goodrobots/devFrame/README.md

# devFrame
The Development Frame, or devFrame, is an easy to build and maintain multicopter frame. 

This is a Work In Progress.

Docs here:  https://goodrobots.github.io/devFrame/

Licensed under CERN OHL v.1.2
