goodrobots/devFrame/docs/_docs/41-basic-camera.md

---
title: "Basic Camera"
permalink: /docs/basic-camera/
---

Coming Soon.
