goodrobots/devFrame/docs/assets/images/battery-etc/bec-cross-mount.jpeg

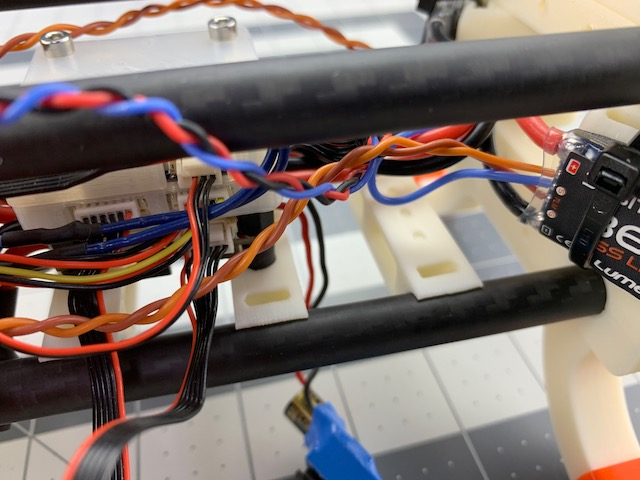
docs/assets/images/battery-etc/bec-cross-mount.jpeg
