goodrobots/devFrame/docs/assets/images/d300 4in1.jpeg

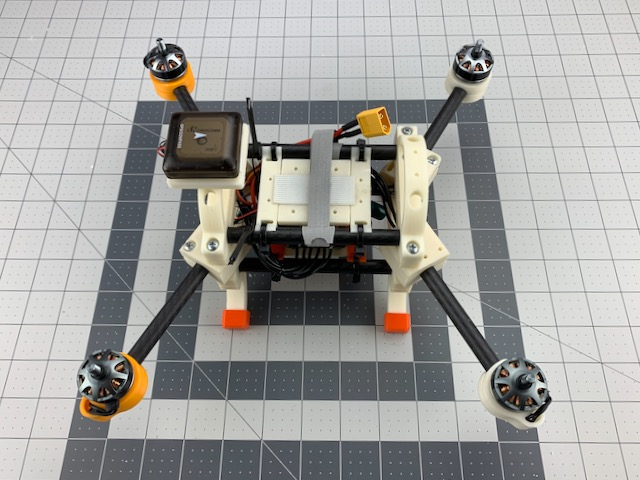
docs/assets/images/d300 4in1.jpeg
