goodrobots/devFrame/docs/assets/images/devFrame-internal-volume-example.jpeg

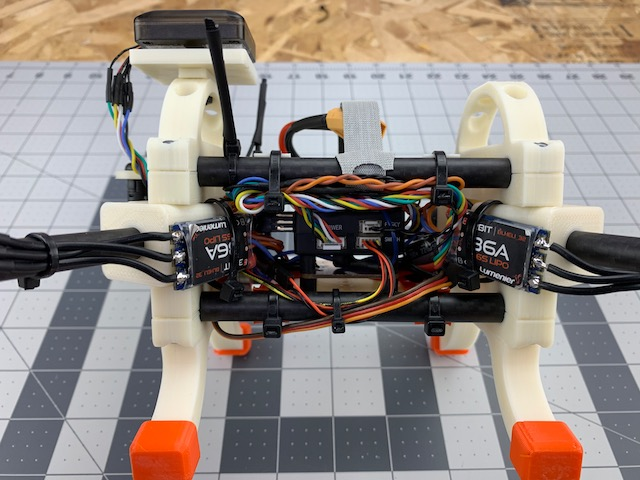
docs/assets/images/devFrame-internal-volume-example.jpeg
