goodrobots/devFrame/docs/assets/images/devFrame-mounts-example.jpeg

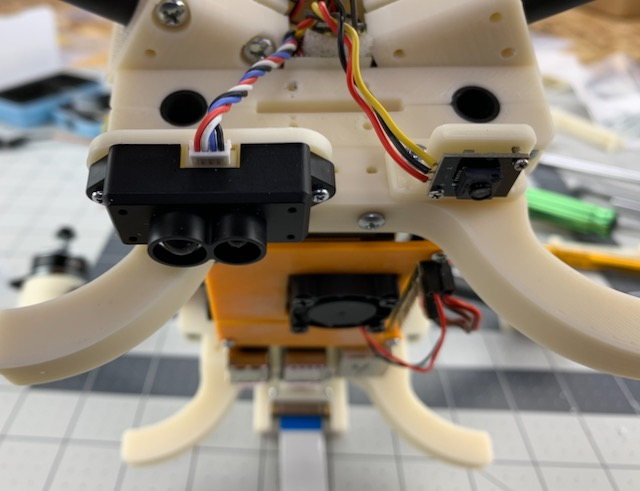
docs/assets/images/devFrame-mounts-example.jpeg
