goodrobots/devFrame/docs/assets/images/frame-details/arm-tube-mount.jpeg

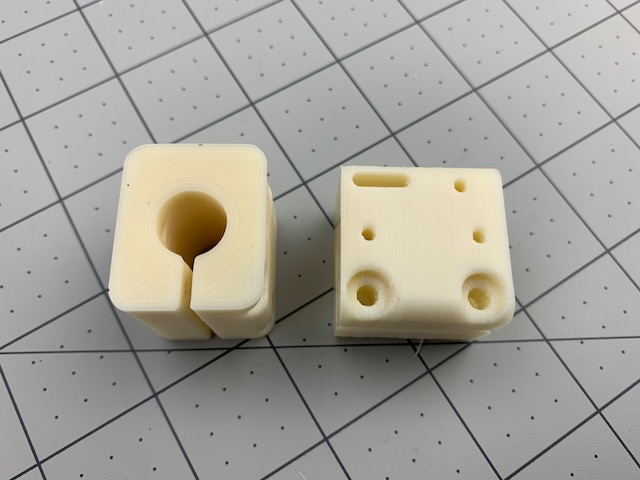
docs/assets/images/frame-details/arm-tube-mount.jpeg
