goodrobots/devFrame/docs/assets/images/frame-details/box-end-roll-cage.jpeg

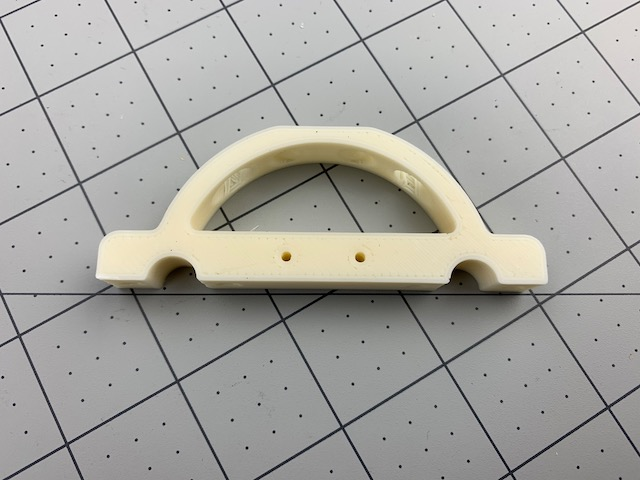
docs/assets/images/frame-details/box-end-roll-cage.jpeg
