goodrobots/devFrame/docs/assets/images/frame-details/box-end-rounded.jpeg

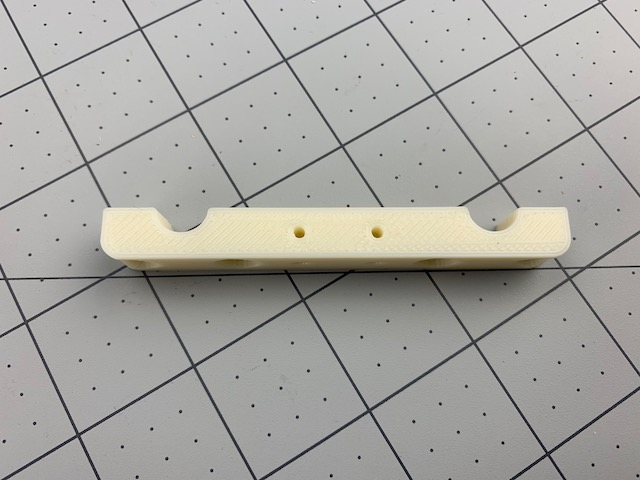
docs/assets/images/frame-details/box-end-rounded.jpeg
