goodrobots/devFrame/docs/assets/images/frame-details/box-end-square.jpeg

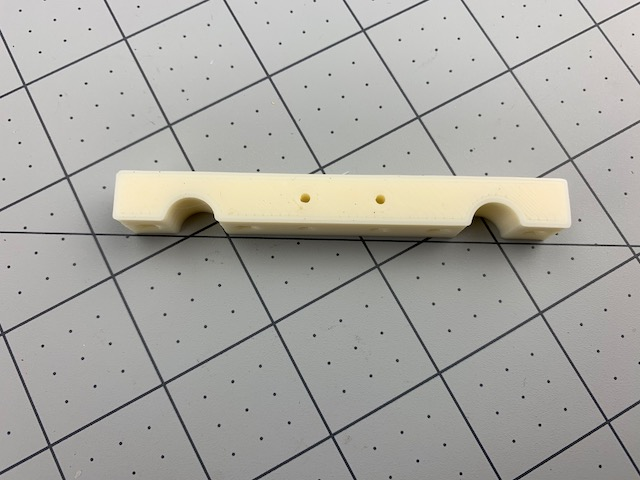
docs/assets/images/frame-details/box-end-square.jpeg
