goodrobots/devFrame/docs/assets/images/frame-details/landing-gear-cap-tpu.jpeg

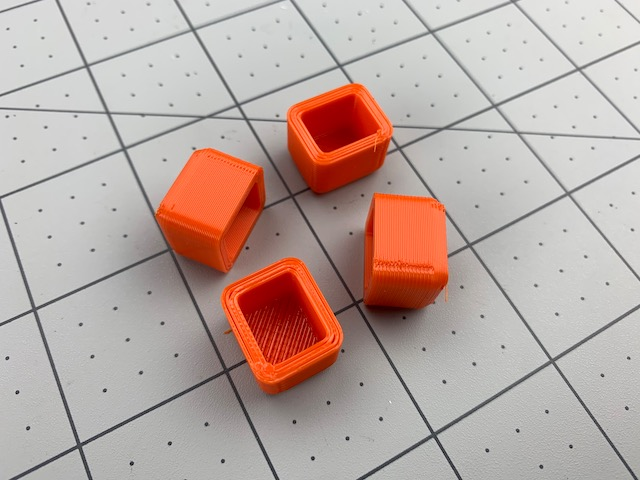
docs/assets/images/frame-details/landing-gear-cap-tpu.jpeg
