goodrobots/devFrame/docs/assets/images/frame-details/landing-gear-spacer.jpeg

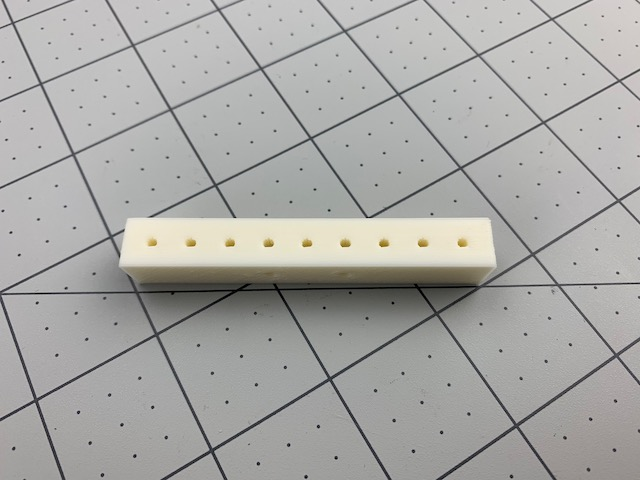
docs/assets/images/frame-details/landing-gear-spacer.jpeg
