goodrobots/devFrame/docs/assets/images/frame-details/landing-gear.jpeg

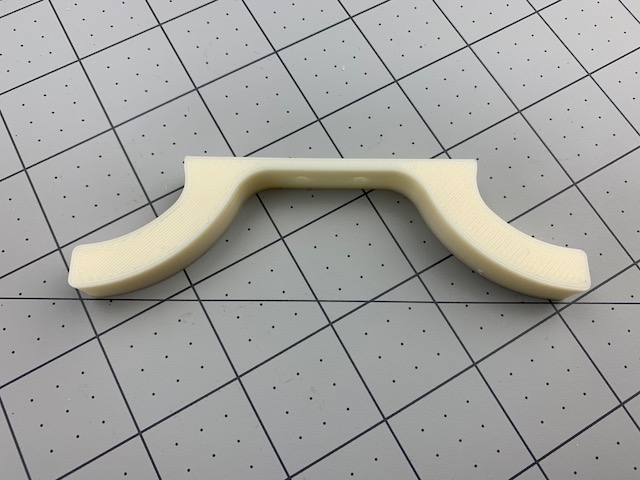
docs/assets/images/frame-details/landing-gear.jpeg
