goodrobots/devFrame/docs/assets/images/frame-details/motor-mount-half.jpeg

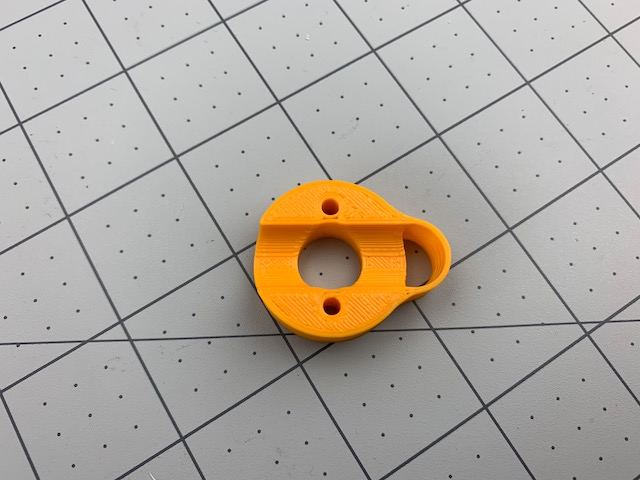
docs/assets/images/frame-details/motor-mount-half.jpeg
