goodrobots/devFrame/docs/assets/images/gps-sensors/gps-tools.jpeg

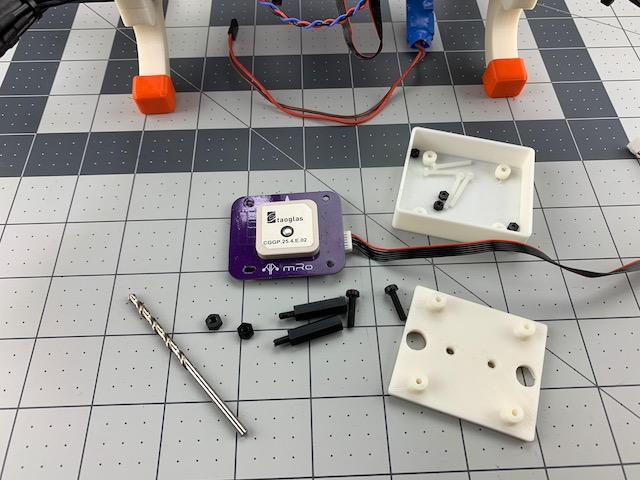
docs/assets/images/gps-sensors/gps-tools.jpeg
