goodrobots/devFrame/docs/assets/images/gps-sensors/receiver-antenna-tools.jpeg

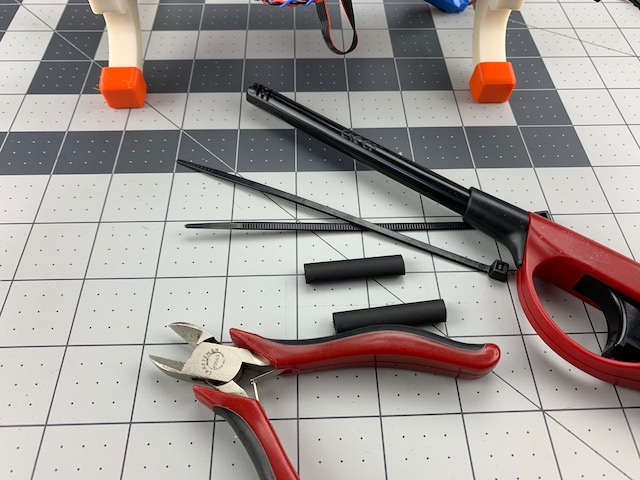
docs/assets/images/gps-sensors/receiver-antenna-tools.jpeg
