goodrobots/devFrame/docs/assets/images/gps-sensors/receiver-cross-mount.jpeg

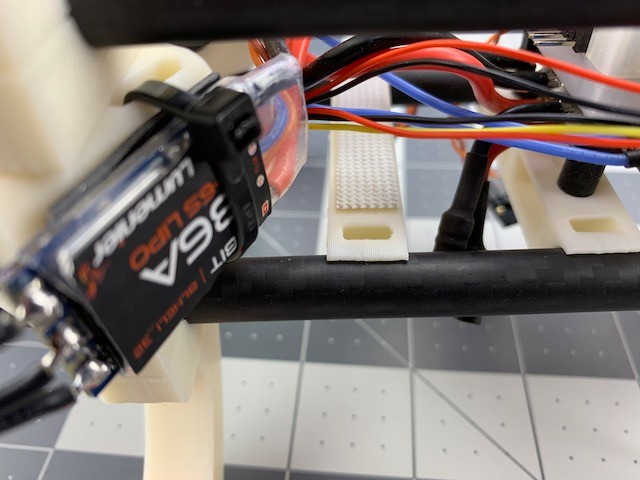
docs/assets/images/gps-sensors/receiver-cross-mount.jpeg
