goodrobots/devFrame/docs/assets/images/gps-sensors/receiver-tools.jpeg

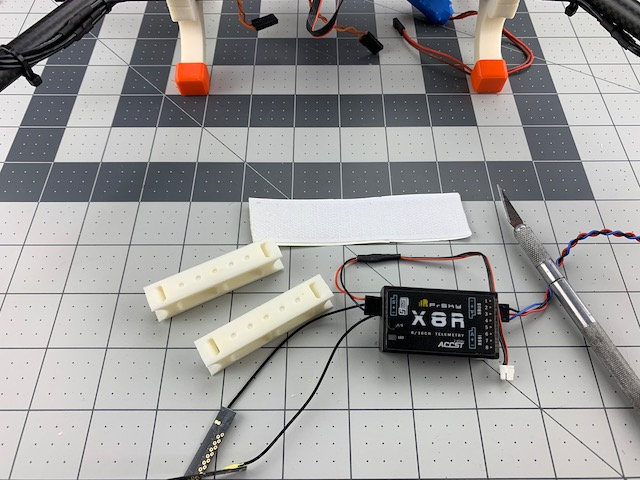
docs/assets/images/gps-sensors/receiver-tools.jpeg
