goodrobots/devFrame/docs/assets/images/gps-sensors/receiver-wires.jpeg

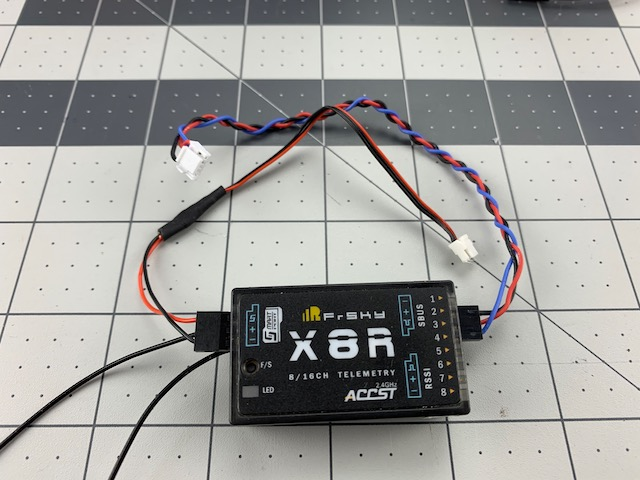
docs/assets/images/gps-sensors/receiver-wires.jpeg
