goodrobots/devFrame/docs/assets/images/gps-sensors/tfmini-back.jpeg

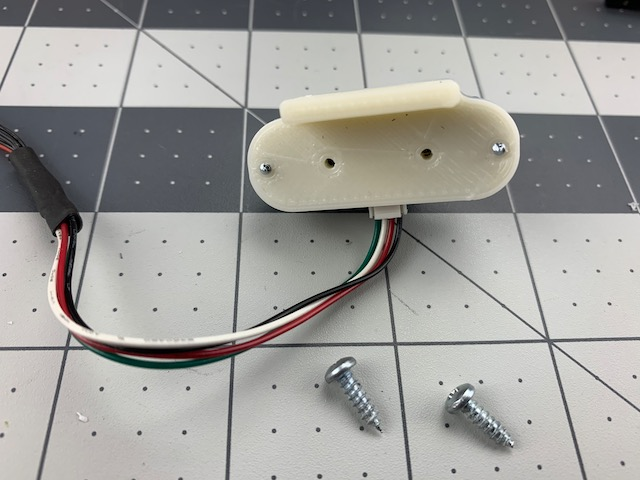
docs/assets/images/gps-sensors/tfmini-back.jpeg
