goodrobots/devFrame/docs/assets/images/gps-sensors/tfmini-front.jpeg

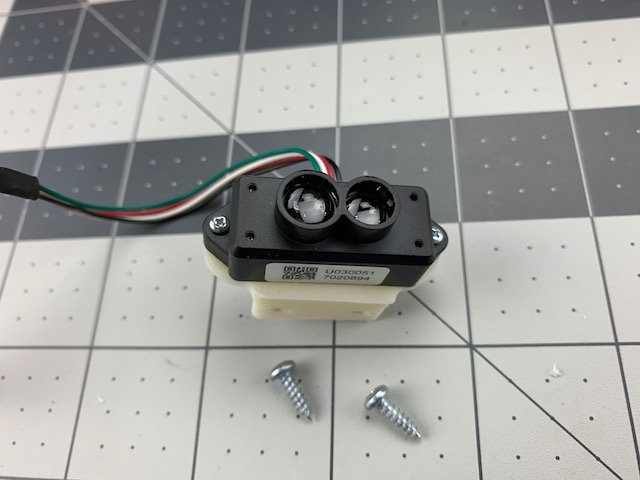
docs/assets/images/gps-sensors/tfmini-front.jpeg
