goodrobots/devFrame/docs/assets/images/gps-sensors/tfmini-prep.jpeg

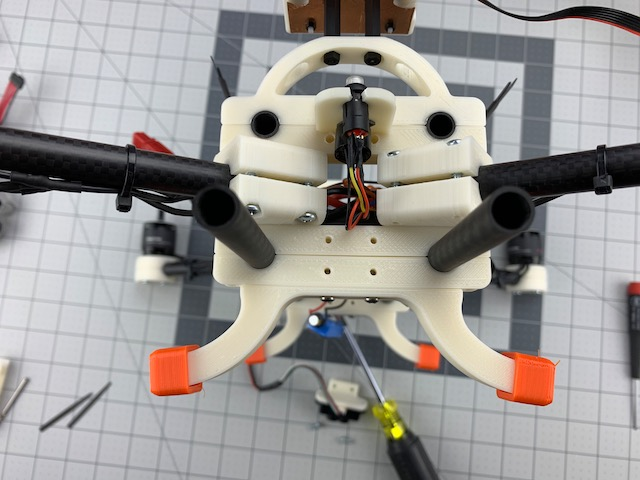
docs/assets/images/gps-sensors/tfmini-prep.jpeg
