goodrobots/devFrame/docs/assets/images/power-esc-motors/5v-bec.jpeg

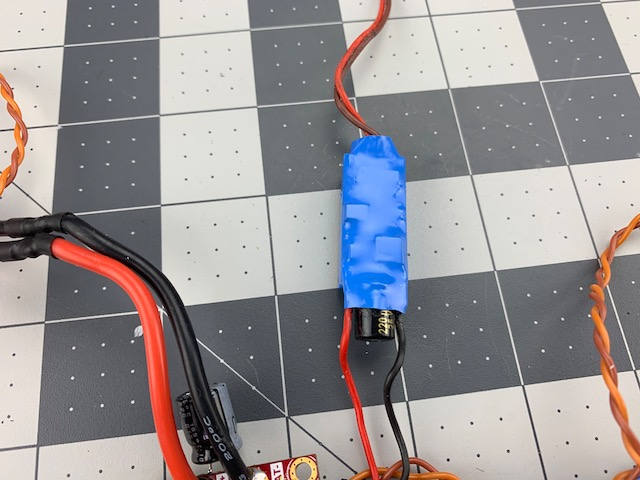
docs/assets/images/power-esc-motors/5v-bec.jpeg
