goodrobots/devFrame/docs/assets/images/power-esc-motors/2213-motor.jpeg

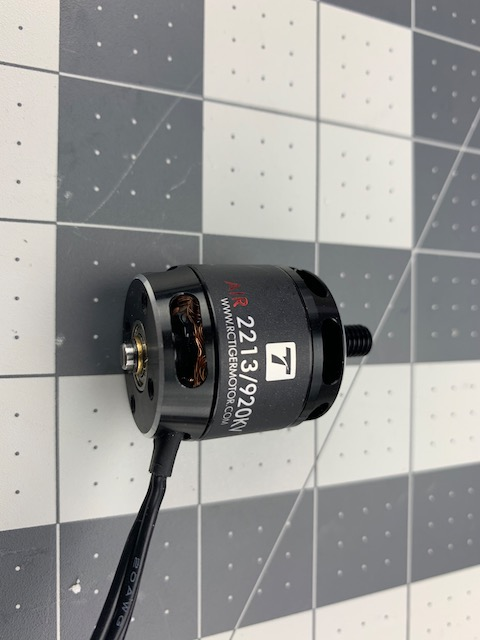
docs/assets/images/power-esc-motors/2213-motor.jpeg
