goodrobots/devFrame/docs/assets/images/power-esc-motors/motor-arm-wire-tools.jpeg

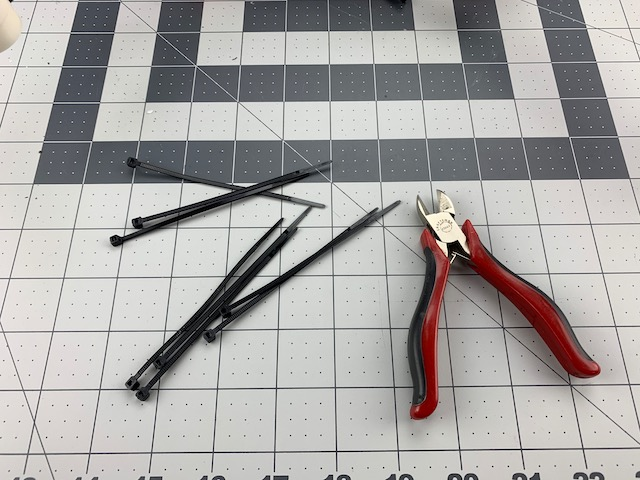
docs/assets/images/power-esc-motors/motor-arm-wire-tools.jpeg
