goodrobots/devFrame/docs/assets/images/power-esc-motors/nylon-standoffs.jpeg

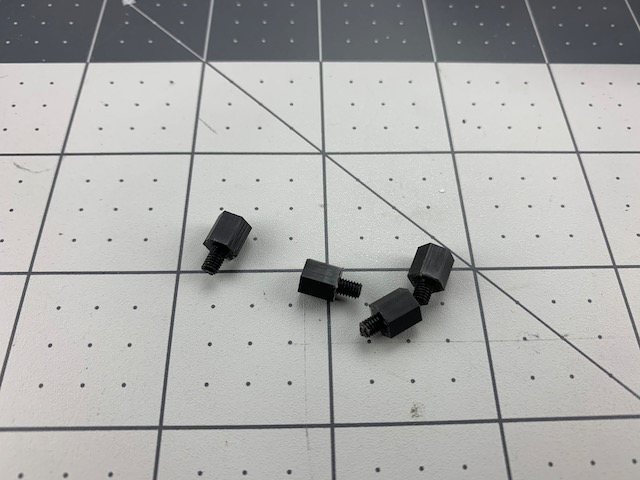
docs/assets/images/power-esc-motors/nylon-standoffs.jpeg
