goodrobots/devFrame/docs/assets/images/power-esc-motors/pdb-acsp4.jpeg

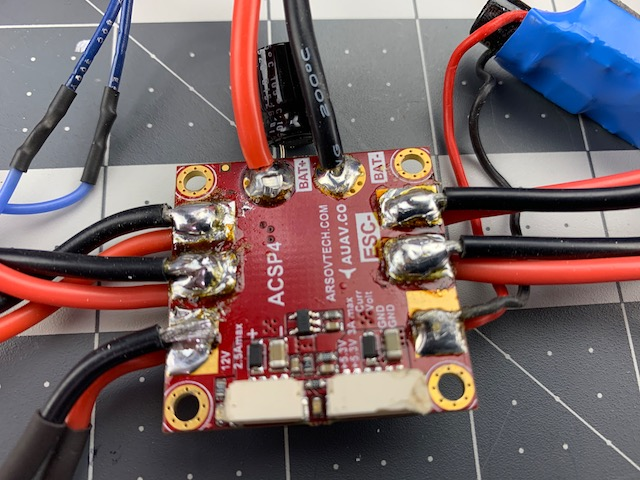
docs/assets/images/power-esc-motors/pdb-acsp4.jpeg
