goodrobots/devFrame/step/Accessory Mounts/Benewake/devFrame TFMini Mount Angle.step

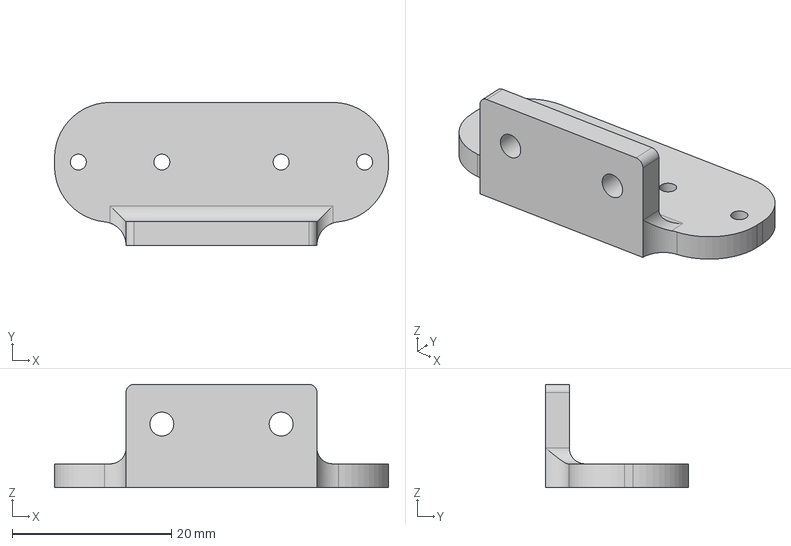
[picture p101: CAD file, 2020-01-14]
step/Accessory Mounts/Benewake/devFrame TFMini Mount Angle.step
42.0 x 18.0 x 13.0 mm
