goodrobots/devFrame/step/Accessory Mounts/CUAV/devFrame CUAV NEO V2 GPS Mount Flat.step

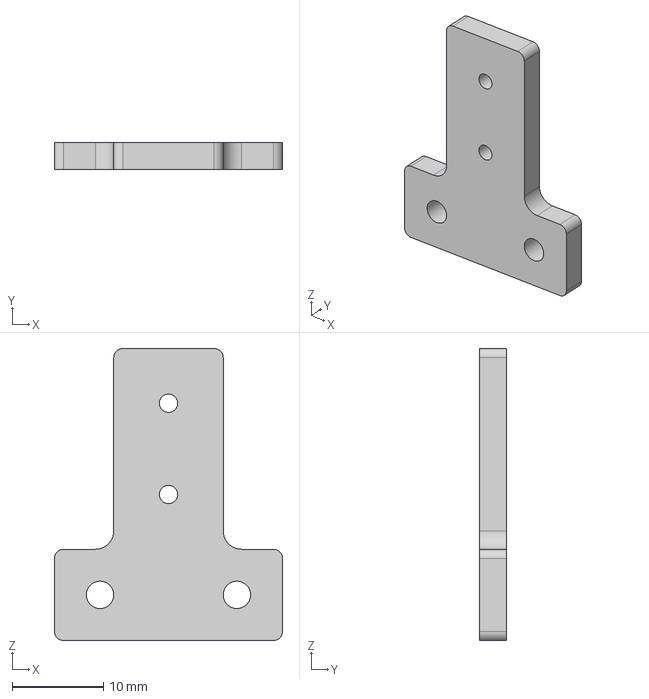
[picture p102: CAD file, 2020-02-13]
step/Accessory Mounts/CUAV/devFrame CUAV NEO V2 GPS Mount Flat.step
25.0 x 3.00 x 32.0 mm
