goodrobots/devFrame/step/Accessory Mounts/Generic/devFrame Platform Mount Shim.step

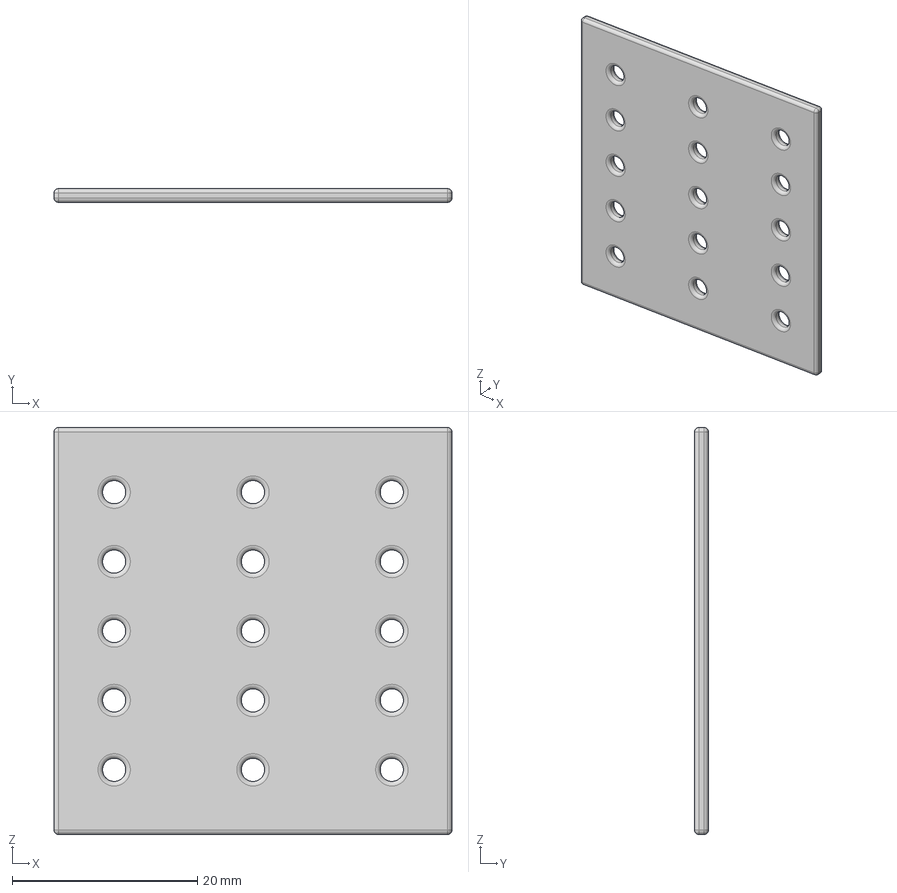
[picture p103: CAD file, 2020-02-05]
step/Accessory Mounts/Generic/devFrame Platform Mount Shim.step
43.0 x 1.50 x 44.0 mm
