goodrobots/devFrame/step/Accessory Mounts/mRo/devFrame mRo GPS Cover.step

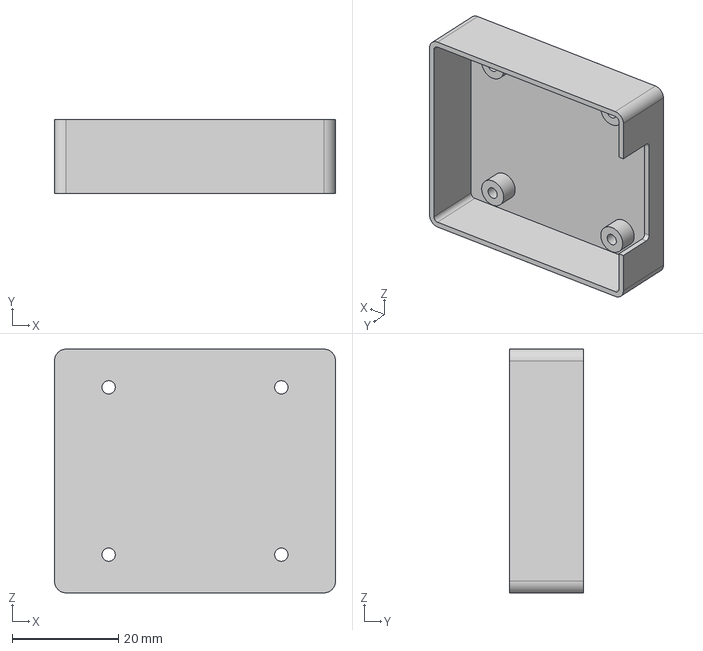
[picture p104: CAD file, 2020-01-12]
step/Accessory Mounts/mRo/devFrame mRo GPS Cover.step
52.9 x 14.0 x 45.9 mm
