goodrobots/devFrame/step/Accessory Mounts/NVIDIA/devFrame NVidia Jetson Nano Mount.step

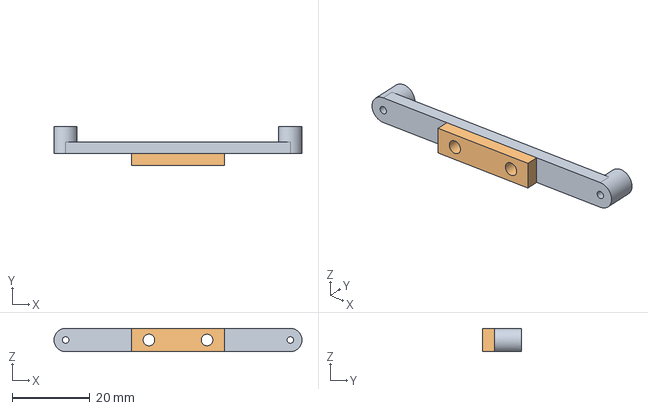
[picture p105: CAD file, 2020-02-10]
step/Accessory Mounts/NVIDIA/devFrame NVidia Jetson Nano Mount.step
64.0 x 10.0 x 6.00 mm
