goodrobots/devFrame/step/Accessory Mounts/RPi/devFrame RPi0 Mount Tall.step

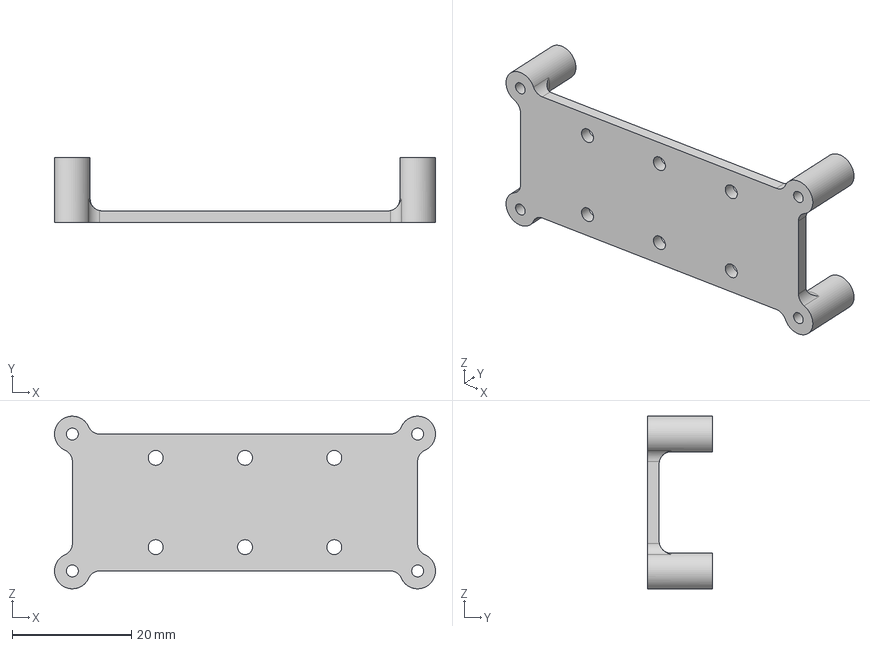
[picture p106: CAD file, 2020-01-19]
step/Accessory Mounts/RPi/devFrame RPi0 Mount Tall.step
64.0 x 11.0 x 29.0 mm
