goodrobots/devFrame/step/Accessory Mounts/Seeed/devFrame Seeed ThoneFlow Mount Flat.step

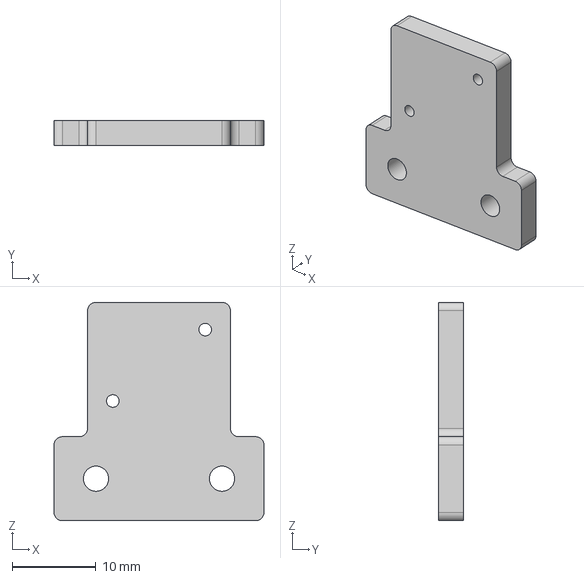
[picture p107: CAD file, 2020-01-25]
step/Accessory Mounts/Seeed/devFrame Seeed ThoneFlow Mount Flat.step
25.0 x 3.00 x 26.0 mm
