goodrobots/devFrame/step/Frame/10mm Arm Tube/devFrame Motor Mount Half 10mm.step

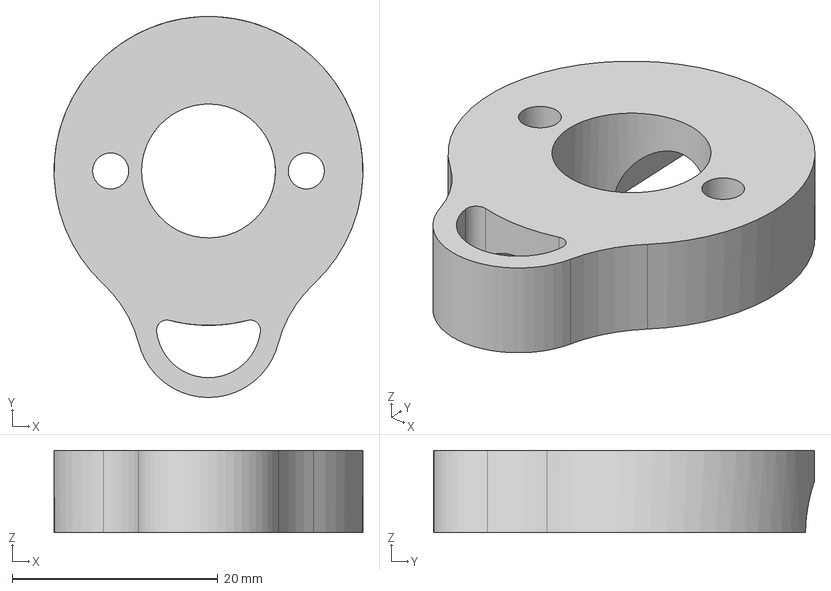
[picture p108: CAD file, 2020-01-12]
step/Frame/10mm Arm Tube/devFrame Motor Mount Half 10mm.step
30.0 x 37.0 x 8.00 mm
