goodrobots/devFrame/step/Frame/12mm Arm Tube/devFrame Motor Mount Half 12mm.step

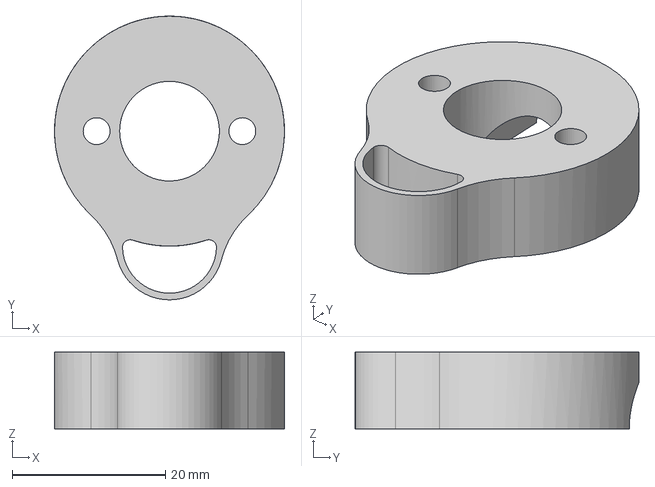
[picture p109: CAD file, 2020-02-03]
step/Frame/12mm Arm Tube/devFrame Motor Mount Half 12mm.step
30.0 x 37.0 x 10.0 mm
