goodrobots/devFrame/step/Frame/devFrame Landing Gear Cap TPU.step

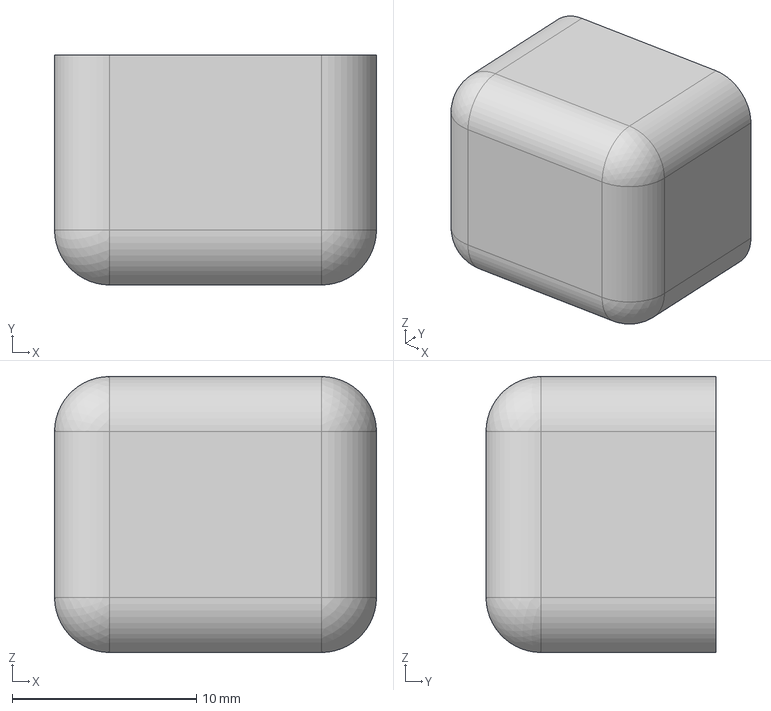
[picture p110: CAD file, 2020-01-25]
step/Frame/devFrame Landing Gear Cap TPU.step
17.5 x 12.5 x 15.0 mm
