goodrobots/devFrame/stl/Accessory Mounts/RPi/devFrame RPi Cam Mount Rear Flat.stl

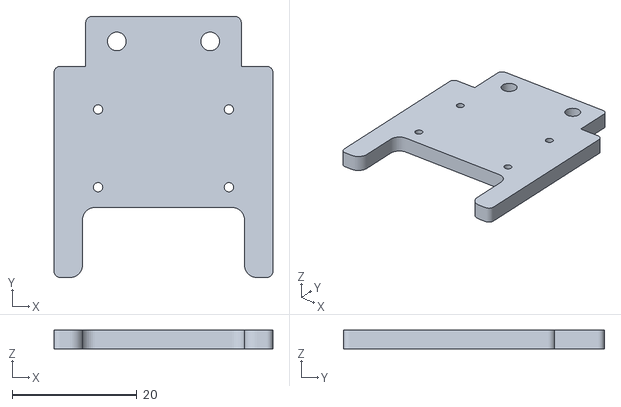
[picture p111: CAD file, 2020-01-14]
stl/Accessory Mounts/RPi/devFrame RPi Cam Mount Rear Flat.stl
35.2 x 41.9 x 3.00
