goodrobots/devFrame/step/Accessory Mounts/Benewake/devFrame TFMini Mount Flat.step

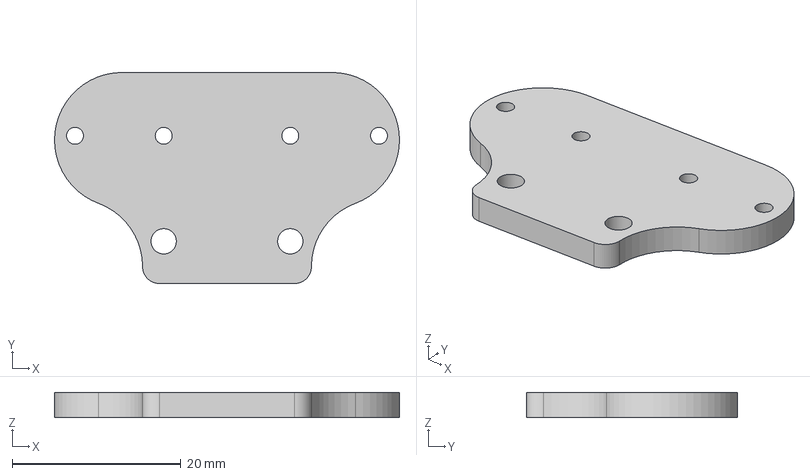
[picture p112: CAD file, 2020-01-14]
step/Accessory Mounts/Benewake/devFrame TFMini Mount Flat.step
40.9 x 25.0 x 3.00 mm
