goodrobots/devFrame/step/Accessory Mounts/CUAV/devFrame CUAV NEO v2 GPS Mount Angle.step

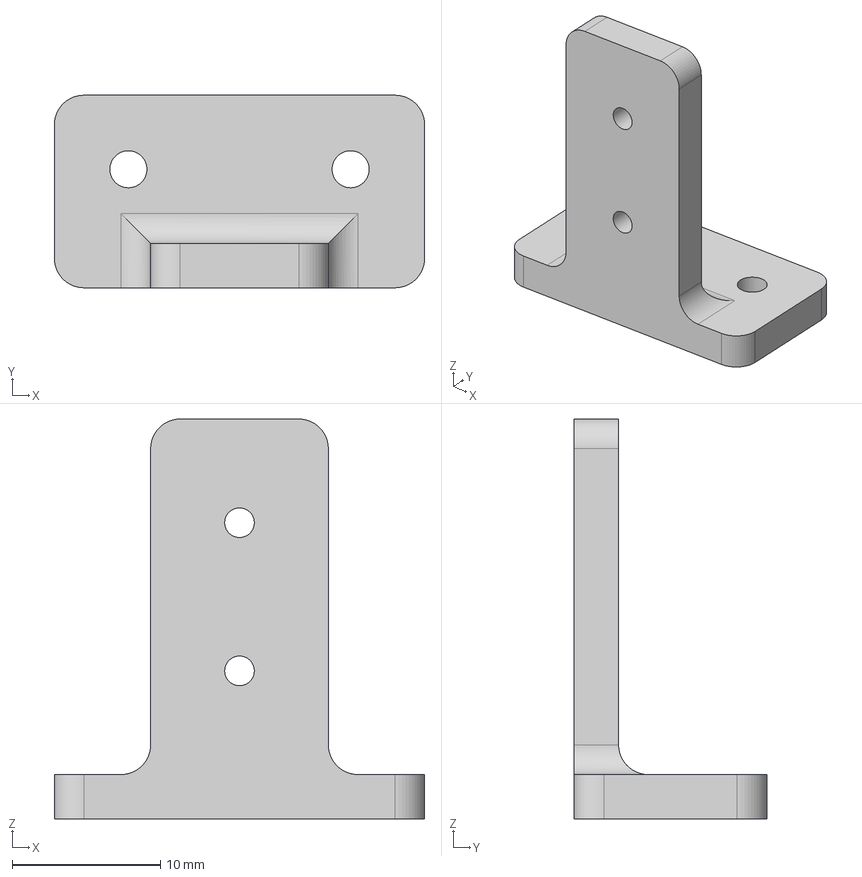
[picture p113: CAD file, 2020-02-13]
step/Accessory Mounts/CUAV/devFrame CUAV NEO v2 GPS Mount Angle.step
25.0 x 13.0 x 27.0 mm
