goodrobots/devFrame/step/Accessory Mounts/Generic/devFrame Platform Mount.step

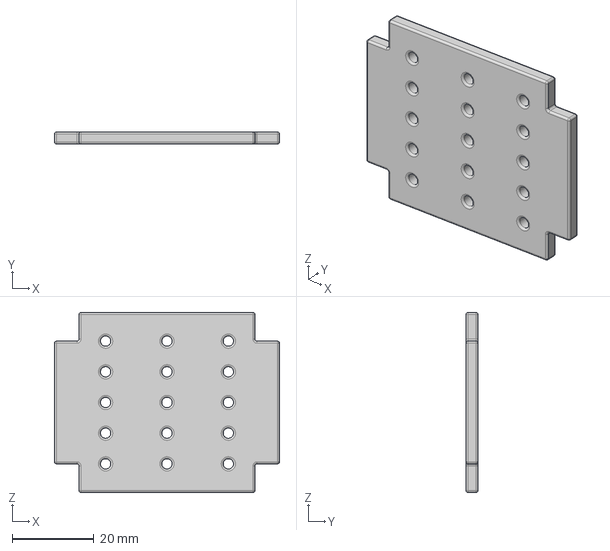
[picture p114: CAD file, 2020-02-05]
step/Accessory Mounts/Generic/devFrame Platform Mount.step
55.0 x 3.00 x 44.0 mm
