goodrobots/devFrame/step/Accessory Mounts/mRo/devFrame mRo GPS Mount.step

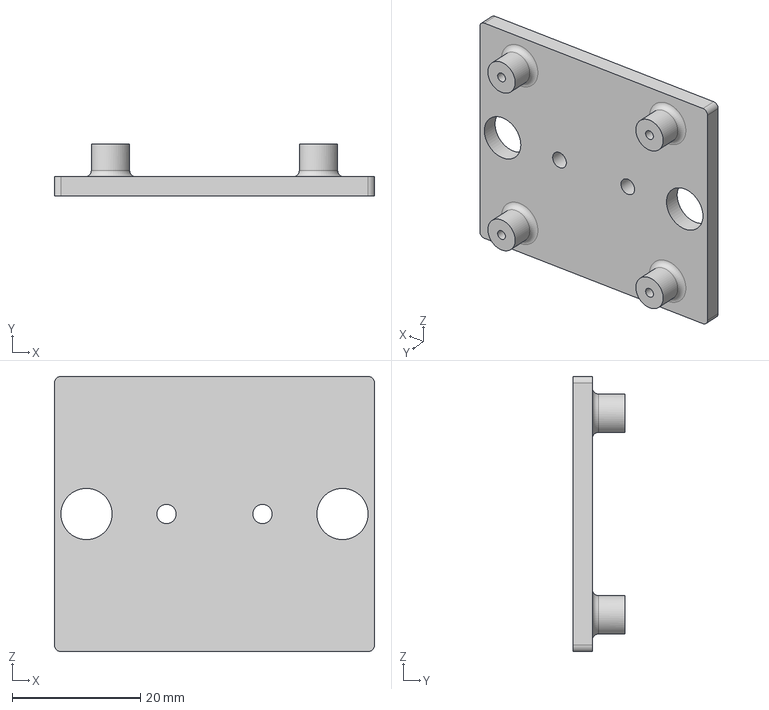
[picture p115: CAD file, 2020-01-12]
step/Accessory Mounts/mRo/devFrame mRo GPS Mount.step
50.0 x 8.10 x 43.0 mm
