goodrobots/devFrame/step/Accessory Mounts/RPi/devFrame RPi0 Mount GPIO.step

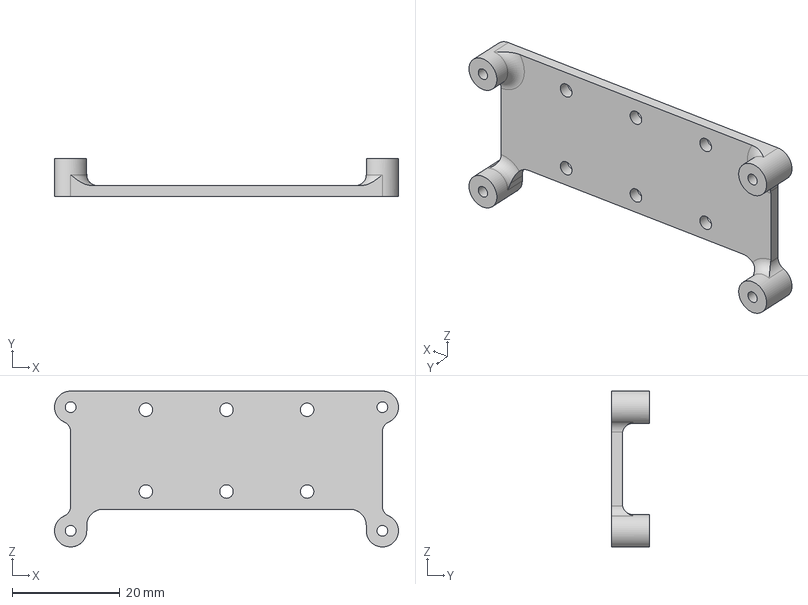
[picture p116: CAD file, 2020-01-14]
step/Accessory Mounts/RPi/devFrame RPi0 Mount GPIO.step
64.0 x 7.00 x 29.0 mm
