goodrobots/devFrame/step/Accessory Mounts/Seeed/devFrame Seeed ThoneFlow Mount Angle.step

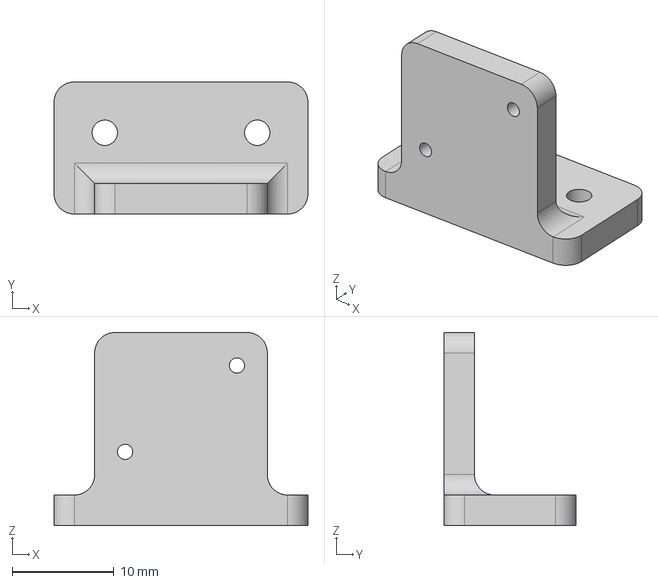
[picture p117: CAD file, 2020-01-25]
step/Accessory Mounts/Seeed/devFrame Seeed ThoneFlow Mount Angle.step
25.0 x 13.0 x 19.0 mm
