goodrobots/devFrame/step/Frame/10mm Arm Tube/devFrame Arm Tube Mount 10mm.step

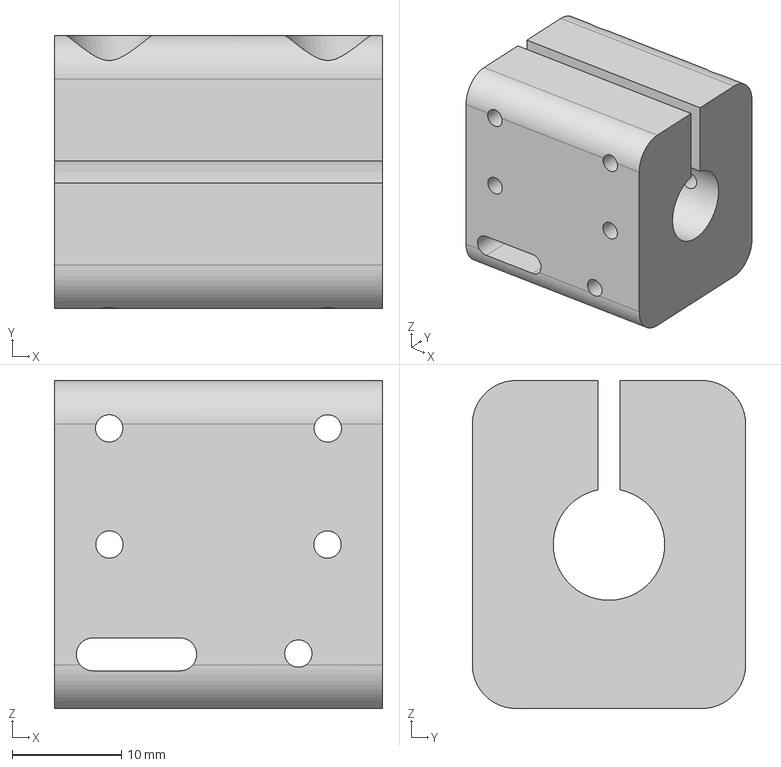
[picture p118: CAD file, 2018-03-31]
step/Frame/10mm Arm Tube/devFrame Arm Tube Mount 10mm.step
30.0 x 25.0 x 30.0 mm
