goodrobots/devFrame/step/Frame/devFrame Landing Gear.step

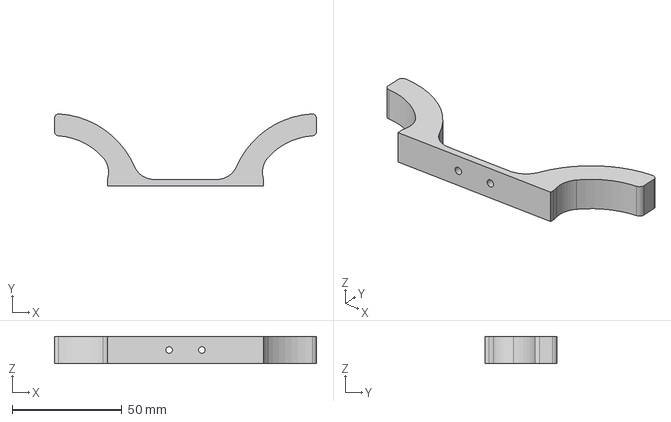
[picture p119: CAD file, 2020-01-19]
step/Frame/devFrame Landing Gear.step
119.6 x 32.9 x 12.5 mm
