goodrobots/devFrame/stl/Accessory Mounts/RPi/devFrame RPi Mount.stl

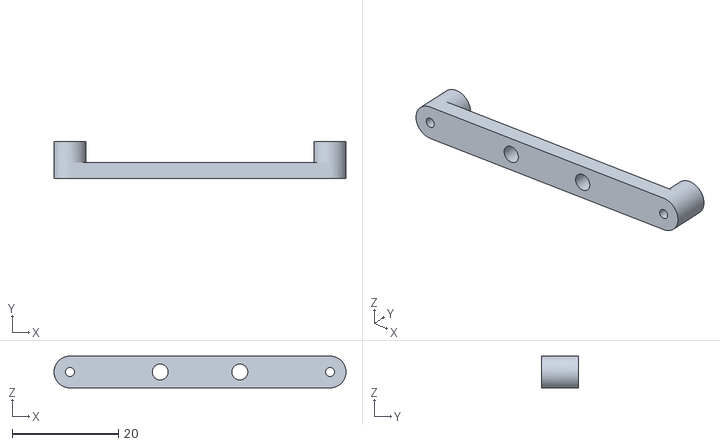
[picture p120: CAD file, 2020-01-12]
stl/Accessory Mounts/RPi/devFrame RPi Mount.stl
55.0 x 7.00 x 6.00
