goodrobots/devFrame/step/Accessory Mounts/CUAV/devFrame CUAV PX4Flow Mount.step

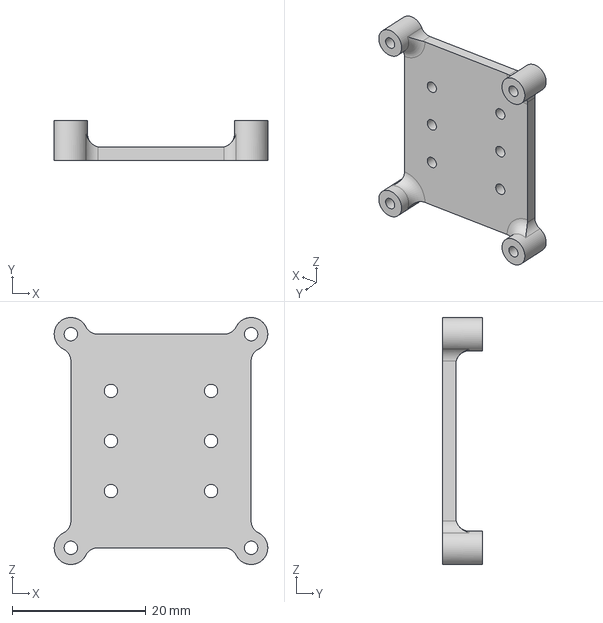
[picture p121: CAD file, 2020-01-14]
step/Accessory Mounts/CUAV/devFrame CUAV PX4Flow Mount.step
32.0 x 6.00 x 37.0 mm
