goodrobots/devFrame/step/Accessory Mounts/Generic/devFrame Cross Mount Vertical.step

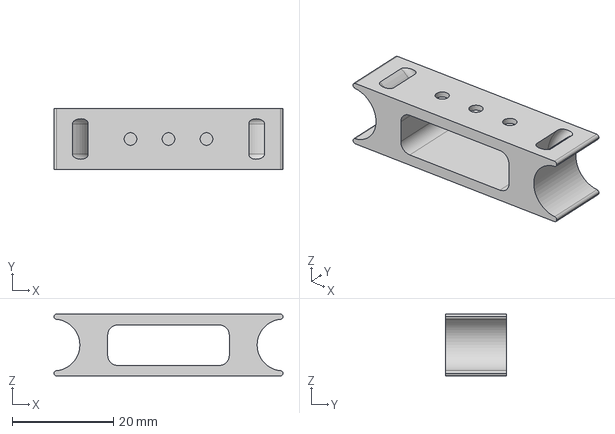
[picture p122: CAD file, 2020-02-03]
step/Accessory Mounts/Generic/devFrame Cross Mount Vertical.step
45.2 x 12.0 x 12.2 mm
