goodrobots/devFrame/step/Frame/devFrame Landing Gear Spacer.step

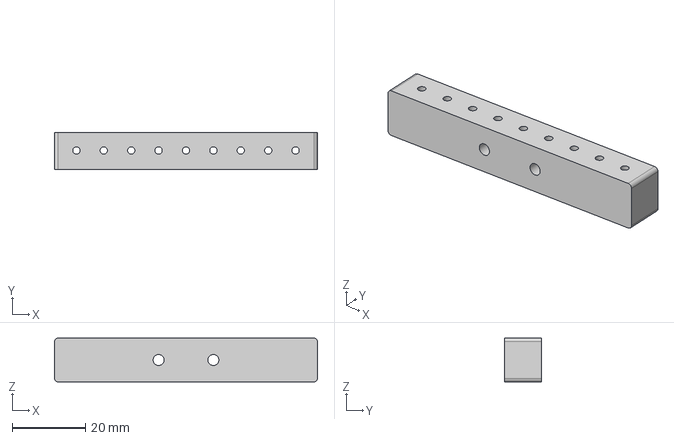
[picture p124: CAD file, 2020-01-14]
step/Frame/devFrame Landing Gear Spacer.step
72.0 x 10.0 x 12.0 mm
