goodrobots/devFrame/step/Accessory Mounts/Generic/devFrame Cross Mount.step

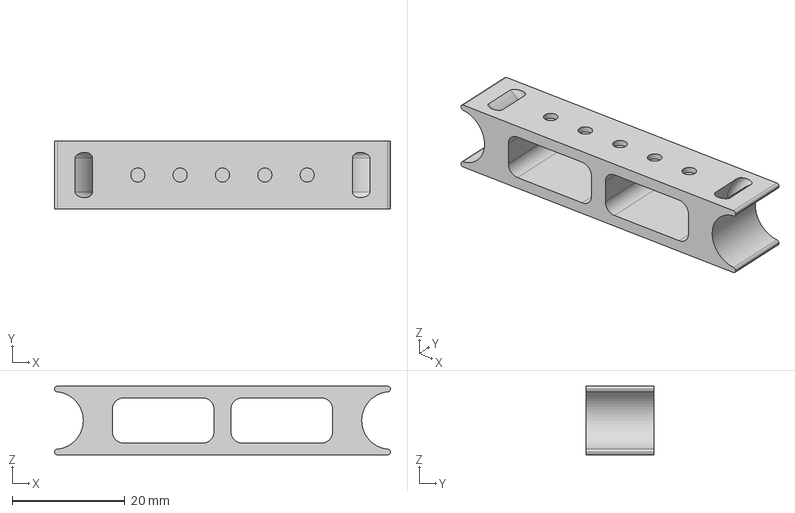
[picture p125: CAD file, 2020-02-03]
step/Accessory Mounts/Generic/devFrame Cross Mount.step
59.5 x 12.0 x 12.2 mm
