goodrobots/devFrame/step/Frame/devFrame Box End Square.step

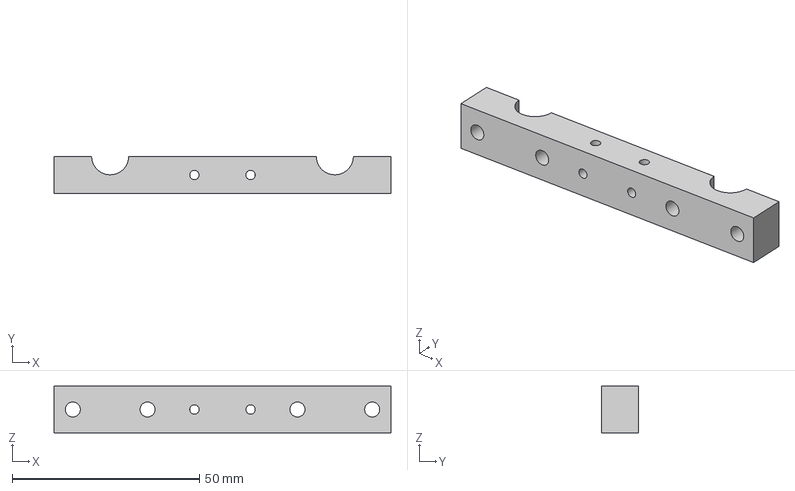
[picture p126: CAD file, 2020-01-12]
step/Frame/devFrame Box End Square.step
90.0 x 10.0 x 12.5 mm
