goodrobots/devFrame/step/Accessory Mounts/RPi/devFrame RPi4 Cover Fan.step

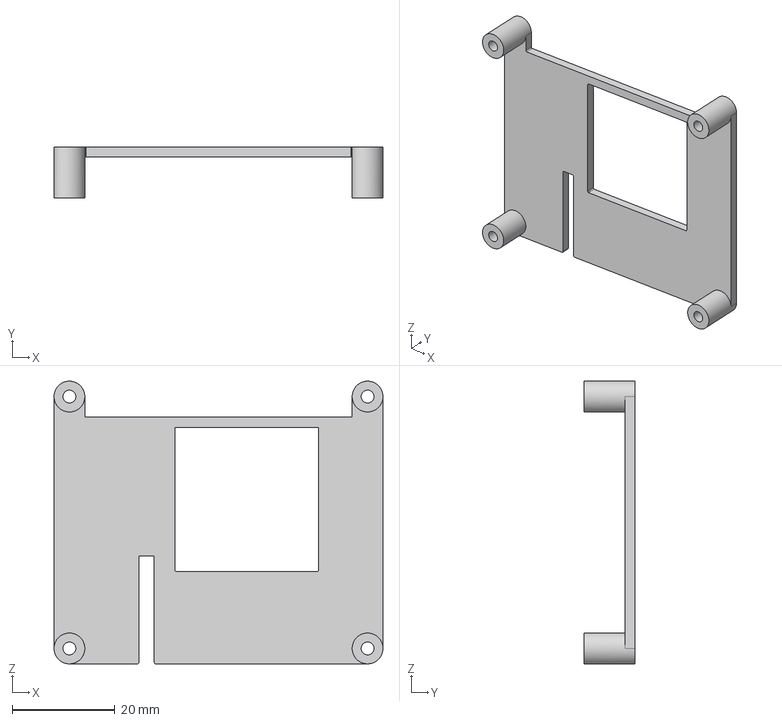
[picture p127: CAD file, 2020-01-14]
step/Accessory Mounts/RPi/devFrame RPi4 Cover Fan.step
64.0 x 10.0 x 55.0 mm
