goodrobots/devFrame/step/Accessory Mounts/Generic/devFrame 246 Standoff Raft.step

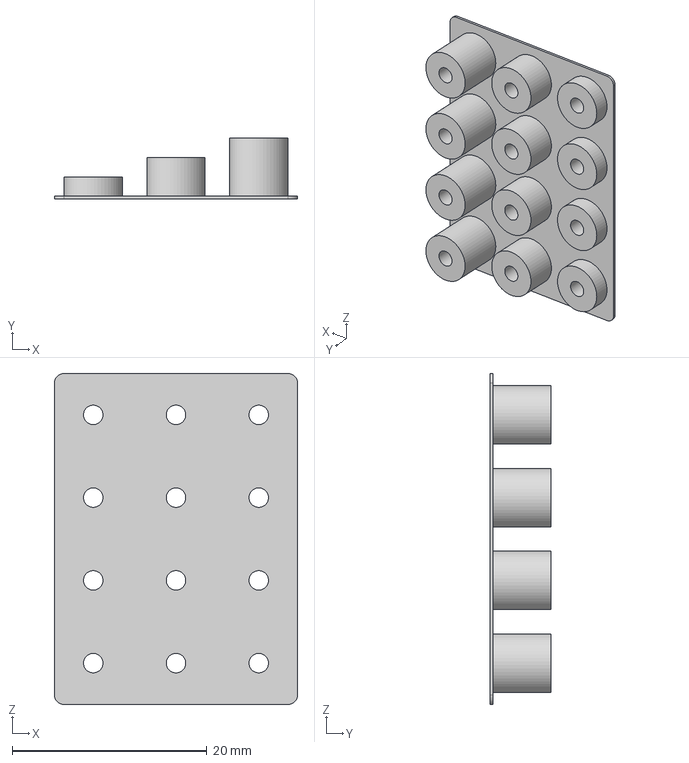
[picture p128: CAD file, 2020-01-25]
step/Accessory Mounts/Generic/devFrame 246 Standoff Raft.step
25.0 x 6.30 x 34.0 mm
