goodrobots/devFrame/step/Accessory Mounts/RPi/devFrame RPi3 Cover Heatsinks.step

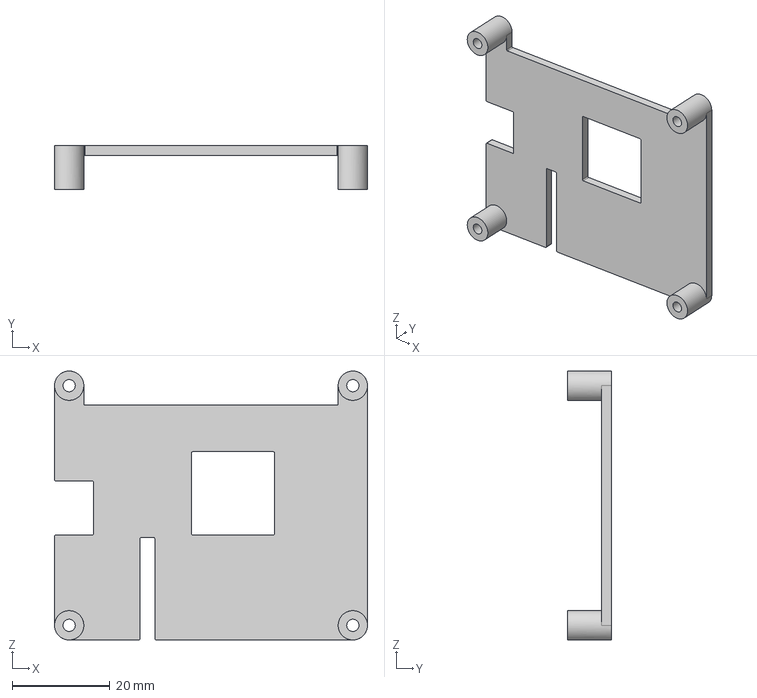
[picture p129: CAD file, 2020-01-14]
step/Accessory Mounts/RPi/devFrame RPi3 Cover Heatsinks.step
64.0 x 9.00 x 55.0 mm
