goodrobots/devFrame/step/Frame/devFrame Box End Roll Cage.step

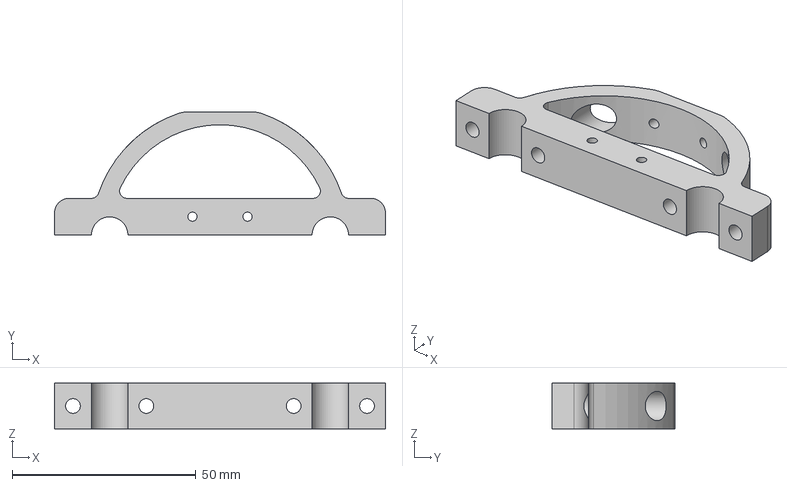
[picture p130: CAD file, 2020-01-12]
step/Frame/devFrame Box End Roll Cage.step
90.0 x 33.5 x 12.5 mm
