goodrobots/devFrame/step/Accessory Mounts/Generic/devFrame 3mm Spacer Short.step

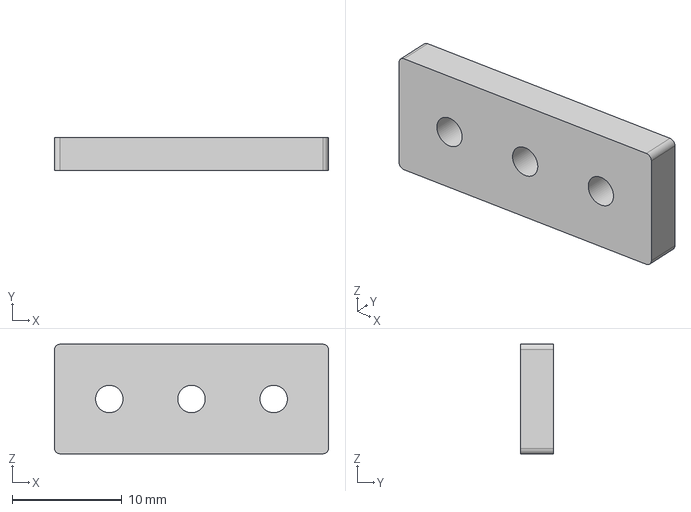
[picture p131: CAD file, 2020-01-25]
step/Accessory Mounts/Generic/devFrame 3mm Spacer Short.step
25.0 x 3.00 x 10.0 mm
