goodrobots/devFrame/step/Accessory Mounts/RPi/devFrame RPi Mount Spacer.step

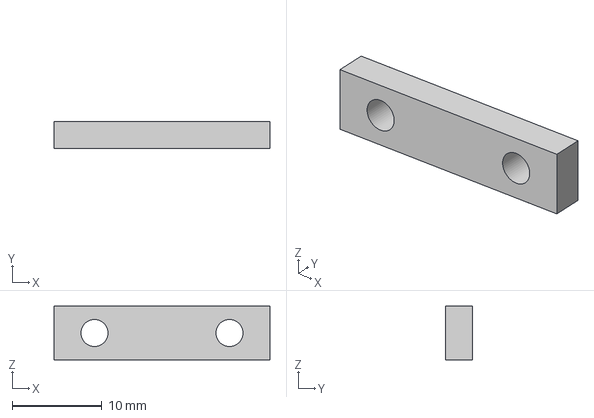
[picture p132: CAD file, 2020-01-12]
step/Accessory Mounts/RPi/devFrame RPi Mount Spacer.step
24.0 x 3.00 x 6.00 mm
