goodrobots/devFrame/step/Accessory Mounts/Generic/devFrame 3mm Spacer Long.step

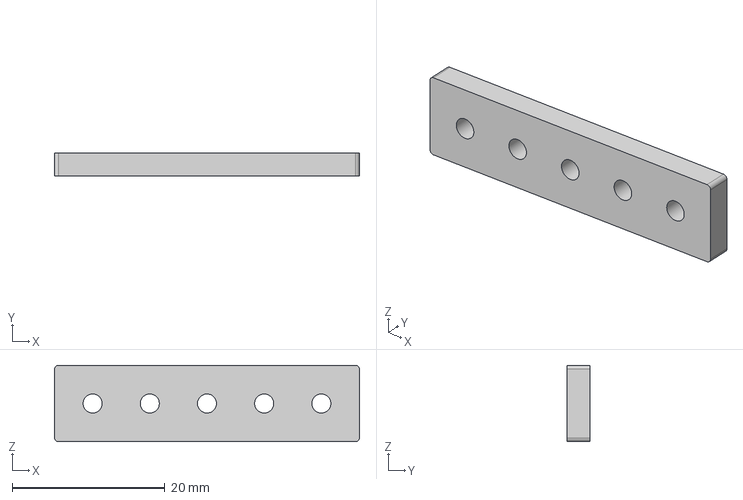
[picture p133: CAD file, 2020-01-25]
step/Accessory Mounts/Generic/devFrame 3mm Spacer Long.step
40.0 x 3.00 x 10.0 mm
