goodrobots/devFrame/step/Accessory Mounts/RPi/devFrame RPi Cam Mount Rear Tilt.step

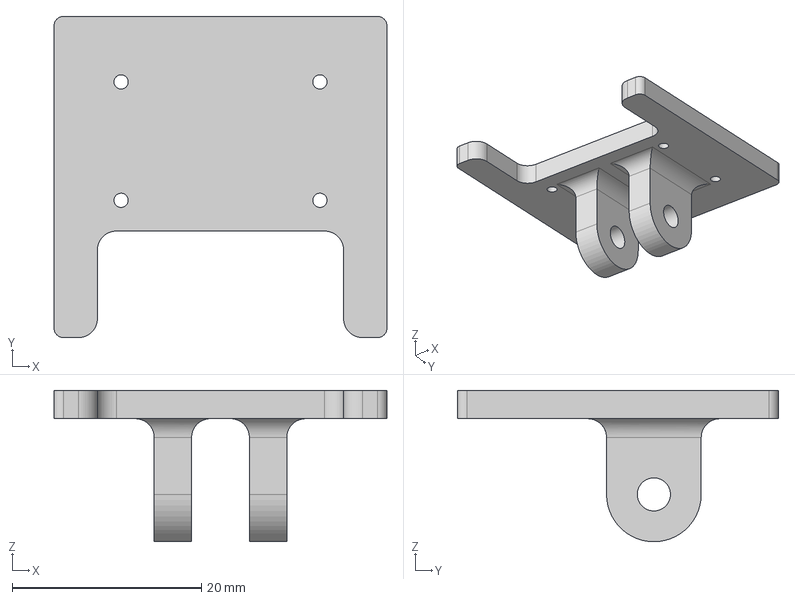
[picture p134: CAD file, 2020-01-12]
step/Accessory Mounts/RPi/devFrame RPi Cam Mount Rear Tilt.step
35.2 x 33.9 x 16.0 mm
