goodrobots/devFrame/step/Accessory Mounts/Generic/devFrame Cross Mount Center Slot.step

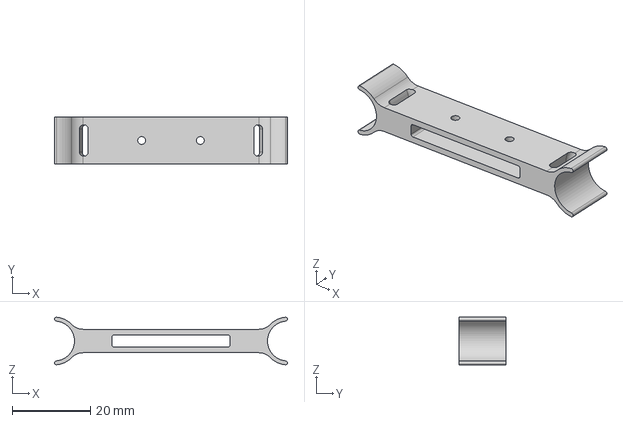
[picture p135: CAD file, 2020-01-19]
step/Accessory Mounts/Generic/devFrame Cross Mount Center Slot.step
59.5 x 12.0 x 12.2 mm
