goodrobots/devFrame/step/Accessory Mounts/RPi/devFrame RPi Cam Mount Front.step

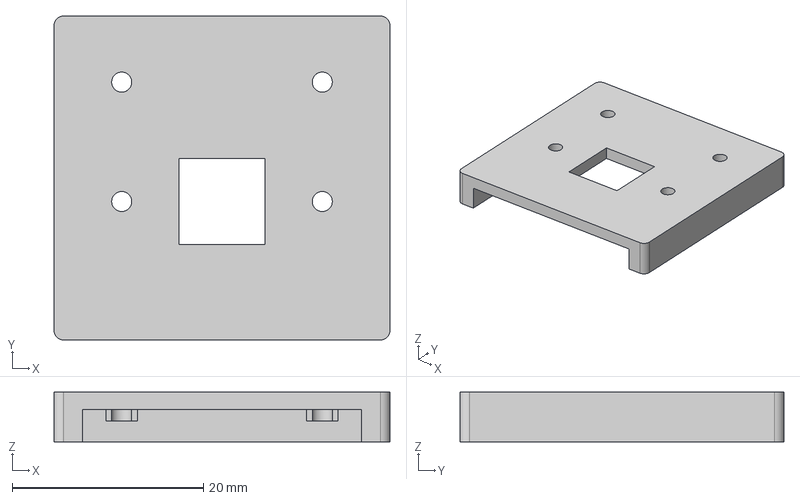
[picture p136: CAD file, 2020-01-12]
step/Accessory Mounts/RPi/devFrame RPi Cam Mount Front.step
35.2 x 33.9 x 5.20 mm
