goodrobots/devFrame/step/Accessory Mounts/Generic/devFrame Multi Mount.step

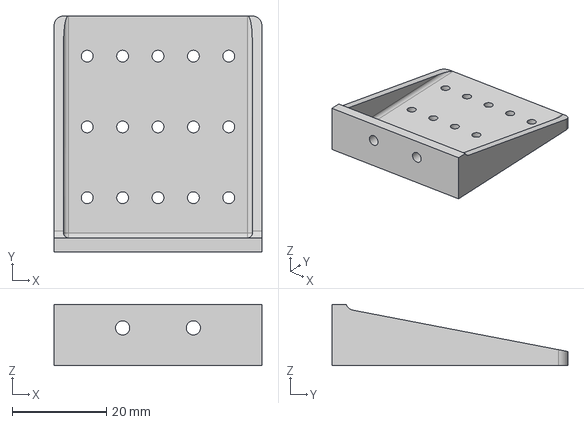
[picture p137: CAD file, 2020-01-14]
step/Accessory Mounts/Generic/devFrame Multi Mount.step
44.0 x 50.0 x 13.0 mm
