goodrobots/devFrame/step/Accessory Mounts/Generic/devFrame Double Angle Mount.step

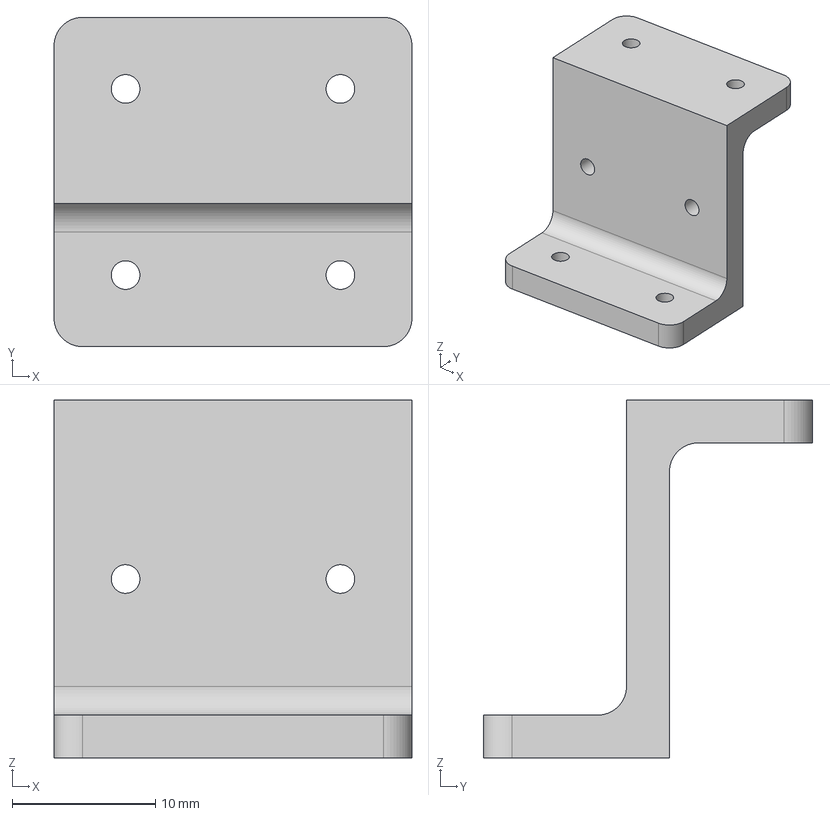
[picture p138: CAD file, 2020-01-14]
step/Accessory Mounts/Generic/devFrame Double Angle Mount.step
25.0 x 23.0 x 25.0 mm
