goodrobots/devFrame/step/Accessory Mounts/Generic/devFrame Sensor Mount Tilt.step

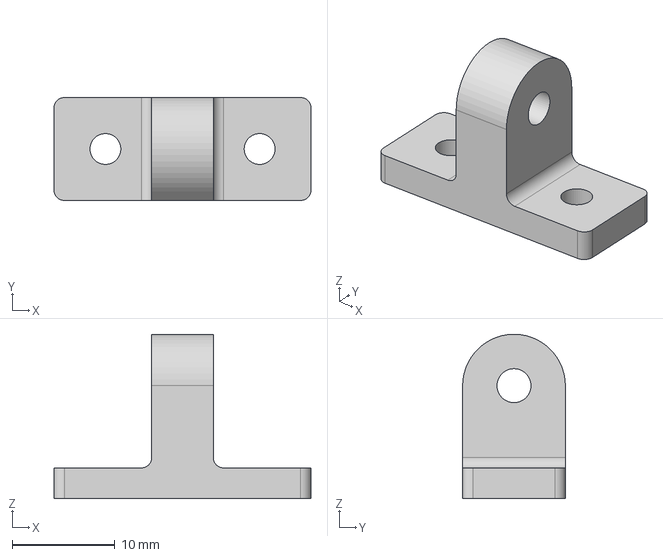
[picture p139: CAD file, 2020-01-12]
step/Accessory Mounts/Generic/devFrame Sensor Mount Tilt.step
25.0 x 10.0 x 16.0 mm
