goodrobots/devFrame/step/Accessory Mounts/Generic/devFrame Antenna Mount Angle.step

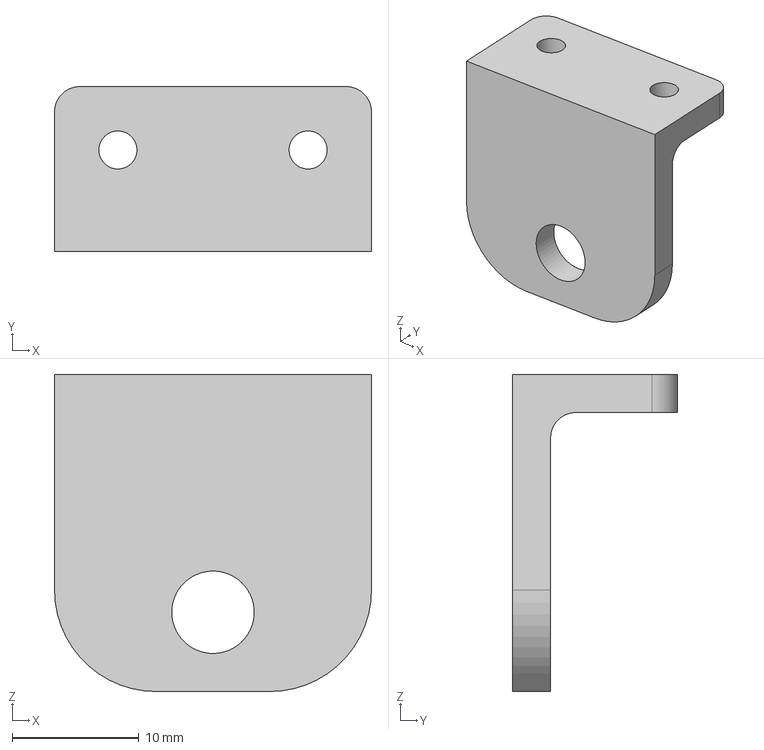
[picture p140: CAD file, 2020-01-12]
step/Accessory Mounts/Generic/devFrame Antenna Mount Angle.step
25.0 x 13.0 x 25.0 mm
