goodrobots/devFrame/step/Accessory Mounts/Generic/devFrame GPS Mount 40x40.step

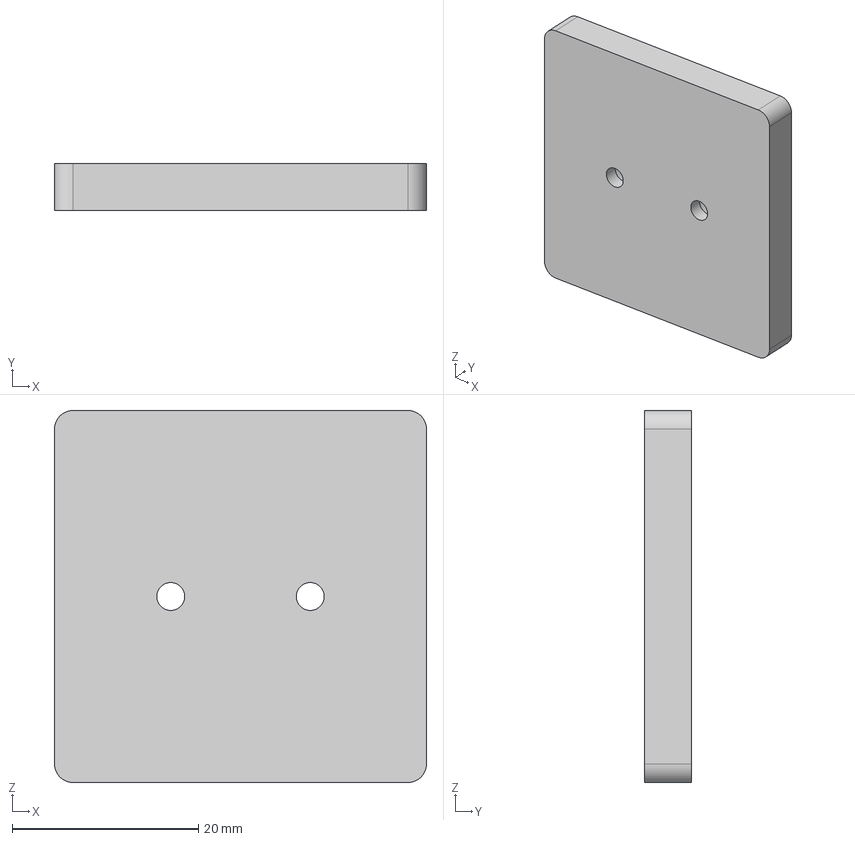
[picture p141: CAD file, 2020-01-12]
step/Accessory Mounts/Generic/devFrame GPS Mount 40x40.step
40.0 x 5.00 x 40.0 mm
