goodrobots/devFrame/step/Accessory Mounts/Generic/devFrame GPS Mount 30x30.step

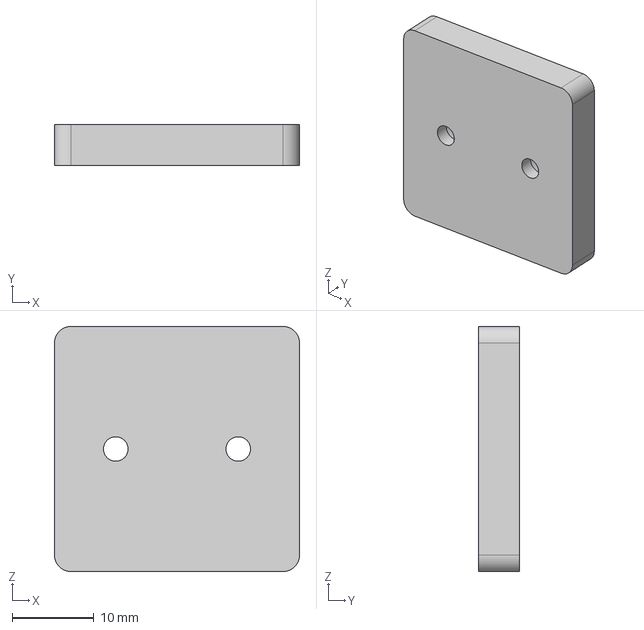
[picture p142: CAD file, 2020-01-12]
step/Accessory Mounts/Generic/devFrame GPS Mount 30x30.step
30.0 x 5.00 x 30.0 mm
