goodrobots/devFrame/step/Accessory Mounts/Generic/devFrame Antenna Mount Flat.step

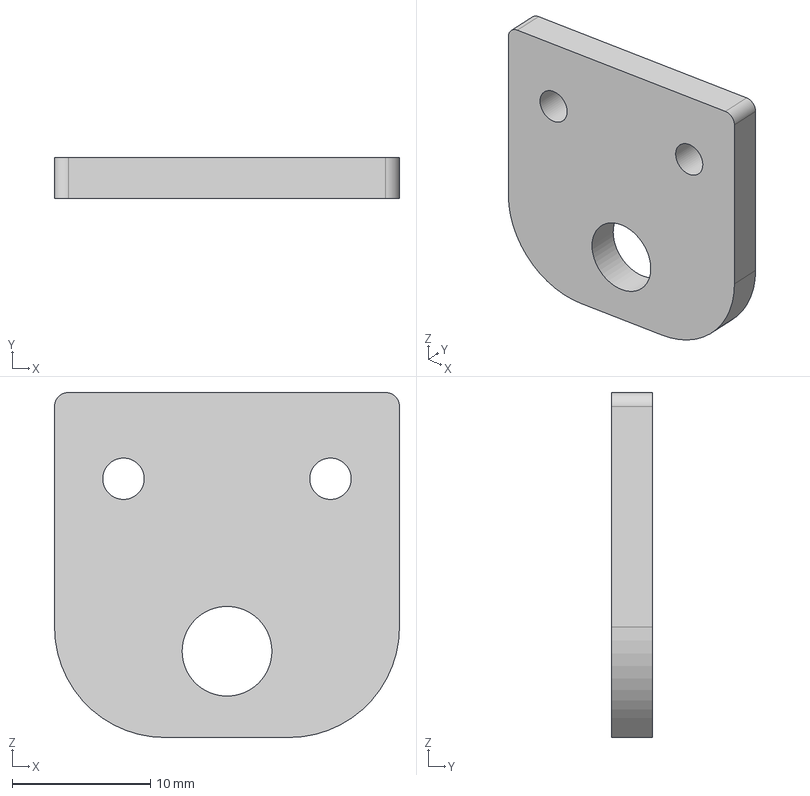
[picture p143: CAD file, 2020-01-12]
step/Accessory Mounts/Generic/devFrame Antenna Mount Flat.step
25.0 x 3.00 x 25.0 mm
