goodrobots/devFrame/(list of files, cad)

Other CAD files:
step/Frame/12mm Arm Tube/devFrame Arm Tube Mount 12mm.step
step/Accessory Mounts/RPi/devFrame RPi Camera Case Rear Flat.step
step/Accessory Mounts/Generic/devFrame Platform Shim.step
step/Frame/devFrame Box End Rounded.step
step/Accessory Mounts/Generic/devFrame Platform Basic.step
step/Accessory Mounts/Generic/devFrame Switch Mount Angle.step
step/Accessory Mounts/Generic/devFrame Switch Mount Flat.step
stl/Accessory Mounts/Benewake/devFrame TFMini Mount Angle.stl
stl/Accessory Mounts/Benewake/devFrame TFMini Mount Flat.stl
stl/Accessory Mounts/CUAV/devFrame CUAV NEO v2 GPS Mount Angle.stl
stl/Accessory Mounts/CUAV/devFrame CUAV NEO v2 GPS Mount Flat.stl
stl/Accessory Mounts/CUAV/devFrame CUAV PX4Flow Mount.stl
stl/Accessory Mounts/Generic/devFrame 246 Standoff Raft.stl
stl/Accessory Mounts/Generic/devFrame 3mm Spacer Long .stl
stl/Accessory Mounts/Generic/devFrame 3mm Spacer Short .stl
stl/Accessory Mounts/Generic/devFrame Antenna Mount Angle.stl
stl/Accessory Mounts/Generic/devFrame Antenna Mount Flat.stl
stl/Accessory Mounts/Generic/devFrame Cross Mount Center Slot.stl
stl/Accessory Mounts/Generic/devFrame Cross Mount Vertical.stl
stl/Accessory Mounts/Generic/devFrame Cross Mount.stl
stl/Accessory Mounts/Generic/devFrame Double Angle Mount.stl
stl/Accessory Mounts/Generic/devFrame GPS Mount 30x30.stl
stl/Accessory Mounts/Generic/devFrame GPS Mount 40x40.stl
stl/Accessory Mounts/Generic/devFrame Multi Mount.stl
stl/Accessory Mounts/Generic/devFrame Platform Mount Shim.stl
stl/Accessory Mounts/Generic/devFrame Platform Mount.stl
stl/Accessory Mounts/Generic/devFrame Sensor Mount Tilt.stl
stl/Accessory Mounts/Generic/devFrame Switch Mount Angle.stl
stl/Accessory Mounts/Generic/devFrame Switch Mount Flat.stl
stl/Accessory Mounts/NVIDIA/devFrame NVIDIA Jetson Nano Mount.stl
stl/Accessory Mounts/RPi/devFrame RPi Cam Mount Front.stl
stl/Accessory Mounts/RPi/devFrame RPi Cam Mount Rear Tilt.stl
stl/Accessory Mounts/RPi/devFrame RPi Mount Spacer.stl
stl/Accessory Mounts/RPi/devFrame RPi0 Mount GPIO.stl
stl/Accessory Mounts/RPi/devFrame RPi0 Mount Tall.stl
stl/Accessory Mounts/RPi/devFrame RPi0 Mount.stl
stl/Accessory Mounts/RPi/devFrame RPi3 Cover Heatsinks.stl
stl/Accessory Mounts/RPi/devFrame RPi4 Cover Fan.stl
stl/Accessory Mounts/Seeed/devFrame Seeed ThoneFlow Mount Angle.stl
stl/Accessory Mounts/Seeed/devFrame Seeed ThoneFlow Mount Flat.stl
stl/Accessory Mounts/mRo/devFrame mRo GPS Cover.stl
stl/Accessory Mounts/mRo/devFrame mRo GPS Mount.stl
stl/Frame/10mm Arm Tube/devFrame Arm Tube Mount 10mm.stl
stl/Frame/10mm Arm Tube/devFrame Motor Mount Half 10mm.stl
stl/Frame/12mm Arm Tube/devFrame Arm Tube Mount 12mm.stl
stl/Frame/12mm Arm Tube/devFrame Motor Mount Half 12mm.stl
stl/Frame/devFrame Box End Roll Cage.stl
stl/Frame/devFrame Box End Rounded.stl
stl/Frame/devFrame Box End Square.stl
stl/Frame/devFrame Landing Gear Cap TPU.stl
stl/Frame/devFrame Landing Gear Spacer.stl
stl/Frame/devFrame Landing Gear.stl
