goodrobots/devFrame/docs/_builds/02-d450.md

---
title: "d450 Mapper"
permalink: /builds/d450/
---

Coming soon.  Using a d450 frame with fixed mount Canon point and shoot as basic mapping platform.
