goodrobots/devFrame/docs/_docs/22-px4-setup.md

---
title: "PX4 Based Setup"
permalink: /docs/px4/
---

PX4 support is planned.  Like to see it sooner?  Contributions welcomed.
