goodrobots/devFrame/docs/_builds/01-d300.md

---
title: "d300 Crash Test Dummy"
permalink: /builds/d300/
---

Coming soon.  A d300 build that I use to test new stuff and generally abuse.
