goodrobots/devFrame/docs/assets/images/power-esc-motors/esc-installed.jpeg

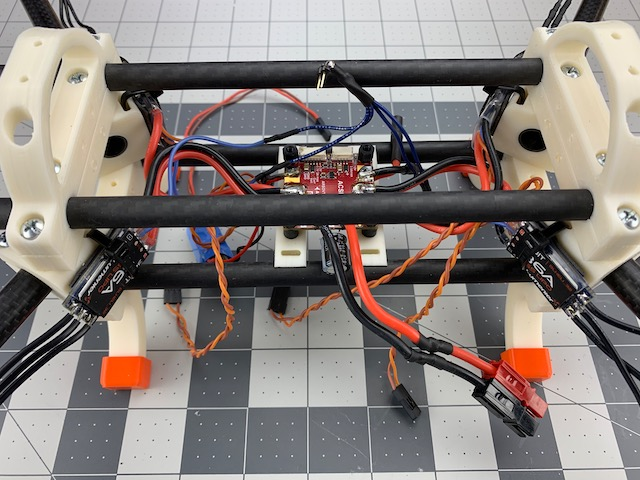
docs/assets/images/power-esc-motors/esc-installed.jpeg
