goodrobots/devFrame/docs/assets/images/power-esc-motors/motors-installed.jpeg

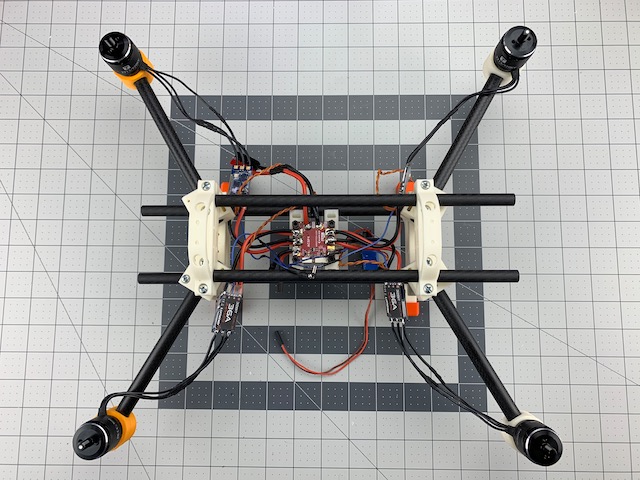
docs/assets/images/power-esc-motors/motors-installed.jpeg
