goodrobots/devFrame/docs/_docs/33-functional-tests.md

---
title: "Functional Check Flights"
permalink: /docs/functional-checks/
---

Coming soon.
