goodrobots/devFrame/docs/assets/images/gps-sensors/gps-shield-experiment.jpeg

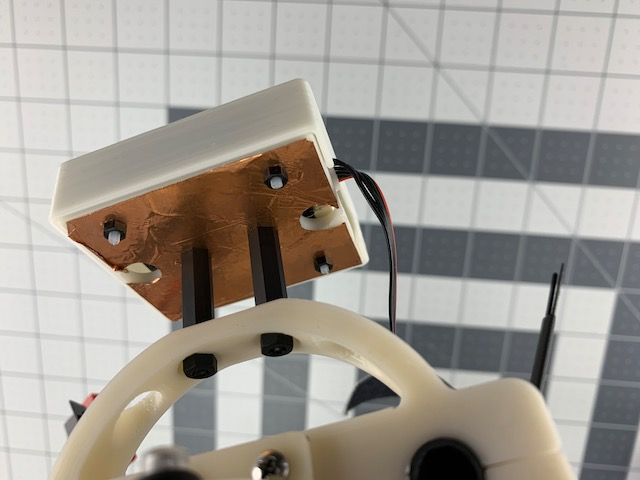
docs/assets/images/gps-sensors/gps-shield-experiment.jpeg
