goodrobots/devFrame/(threads)

Thread 1 (2018-01-13):

Integrate retractable landing gear

fnoop, 2018-01-13:
eg. Tarot TL65B44

 - Looks pretty(er)
 - Makes people go 'ooh'
 - Removes legs out of way of cameras, sensors etc
 - Makes handling better (less swinging weight)

cglusky, 2018-01-13:
I have a set on order so I can test.

Likely best method is to use a plate between them and use antivibe mounts to clamp to bottom box tubes.

You can see how they are doing it for these...

https://www.banggood.com/HML650-Retractable-Folding-Landing-Gear-For-Tarot-650-680pro-HMF-S550-p-941639.html

cglusky, 2018-04-29:
I have these in the shop.  I will design and test a mount but not sure it makes sense to use these in the D500 build.  Might make most sense to just add it to the wiki as an option.  They are heavy and I don't think most people will use them.

cglusky, 2020-01-07:
For d500 which is on hold until people say they want it.  Many 450 class frames out there to use.

Closed 2020-01-07.

Thread 2 (2018-01-13):

Design Tube Hangars

cglusky, 2018-01-13:
COTS example for M10

https://www.amazon.com/Tarot-Multi-Rotor-Helicopter-Part/dp/B00O0QE3N0

Need a printable part that can support TPE insert

cglusky, 2018-05-20:
Leave to COTS parts for now.  If there is interest in people printing with TPE etc then we can reopen.

Closed 2018-05-20.

Thread 10 (2018-03-29):

Raspi Zero Case

cglusky, 2018-03-29:
perhaps with wifi support

fnoop, 2018-03-30:
The official raspberry pi case is cheap and really good.  It comes with three faces including a nice one for the camera

cglusky, 2018-04-11:
this may only be for the top/cover to integrate the wifi module i have.  not very universal so still TBD>  official case as is nice but has a curved top which can make it hard to stack stuff on top.  other COTS options though.

cglusky, 2018-04-17:
yep.  eventually need a case system that is more stackable.  low pri for now as there are many COTS options.

Closed 2018-04-17.

Thread 5 (2018-03-29):

Landing Gear

cglusky, 2018-03-29:

fnoop, 2018-03-30:
Feet bumps!

fnoop, 2018-04-02:
You could make the printed motor mounts with legs/feet on the bottom?

cglusky, 2018-04-11:
v1 published. needs more testing.  first version may need to become separate parts.

Closed 2018-04-11.

Thread 7 (2018-03-29):

Raspi Cam Case and Mount

cglusky, 2018-03-29:

fnoop, 2018-03-30:
Would be super nice if it could have a pitch servo :)

cglusky, 2018-04-17:
designed for # 4 x 0.5in screw for tilt clamp.  A 3mm with nut will also work and less likely to strip.

Closed 2018-04-17.

Thread 9 (2018-03-29):

Prop Guards

cglusky, 2018-03-29:

cglusky, 2018-05-12:
need to use some CF tube and flat here to make it more universal.  printed parts will just be connectors.  motor mounts can incorporate holes for press fit tubes.

cglusky, 2018-05-12:
just using 3mm x 1mm flat CF.  three strips from motor mount to three connectors.  CF strip can be cut to legth per rotor diam.  cutting CF will be a requirement.  unavoidable here.  COTS stuff also an option if cutting CF is not something users wants to tackle.

cglusky, 2018-05-12:
Hub and spoke design.  Motor mount is hub with 3 x spokees and connectors.  New motor mounts with wire protection also have 3mm x 1mm slots for carbon fiber strip.

TODO:

1.   Order 3mm CF
2.   Design spoke connectors
3.  Print/Build/Test

cglusky, 2018-05-20:
This is a good way to produce some nasty vibrations.  May need to change slot on motor mount to handle 6mm x 1mm carbon flat.  Waiting on samples to make sure it's a good size for this application.

cglusky, 2018-05-21:
Looks like 3mm rod is way to go.  Flats not going to work very well.

cglusky, 2020-01-07:
Available online cheaper and easier than we can build one.

Closed 2020-01-07.

Thread 11 (2018-04-02):

TFMini Mount

cglusky, 2018-04-02:
front/back as well as bottom facing mount options

cglusky, 2018-04-17:
adapter needs to support 14mm sensor mount to 36mm on center

cglusky, 2020-01-08:
flat and angled mount now support 15mm spacing

fnoop, 2020-01-08:
Commit?

cglusky, 2020-01-09:
This should close with RC1 if I am using my commit messages right.

Closed 2020-01-12.

Thread 12 (2018-04-11):

Generic GPS Mount

cglusky, 2018-04-11:
Design and print flat rectangle mount for GPS.  Will screw to roll cage and use double sided tape for mounting GPS module.  This will be OK for GPS modules that come in plastic cases.  Will need specific mounts for others such as MRobotics units.

cglusky, 2018-04-17:
40 x 40 is initial deign.  could be smaller.  max area to allow space for Velcro or double sided tape.

Closed 2018-04-17.

Thread 13 (2018-04-15):

Initial Sensor Mount Standard

cglusky, 2018-04-15:
These are the small holes found all over the plastic parts that are not used for assembling the main frame clamps.

Going to use 14mm spacing with 2.5mm diameter holes.  Mostly driven by the way the roll cage design turned out.

The frame is built using #6 screws since they are easy to find at the right lengths.  #4 screws are also easy to source at the shorter lengths (<1/2in) required for sensor/accessory mounting.  2.5mm holes work well for #4 screws.

This requires all files to change.

Thread 14 (2018-04-15):

Separate Landing Gear form End Clamp B

cglusky, 2018-04-15:
Current landing gear integrated with End Clamp B suck.  They are too weak.  Going to make them a separate part so we do not need the through hole that causes the stress riser and subsequent failure of the gear.

cglusky, 2018-04-16:
done.  needs testing.  using #4 screws to mount so now the issue will be shear and/or tear out.

Closed 2018-04-16.

Thread 16 (2018-04-17):

Tilt Servo Mount

cglusky, 2018-04-17:
Need an easy way to mount a micro servo for things like Raspi Cam tilt.

cglusky, 2018-05-20:
Target servo will be HiTec HS-5065MG.

cglusky, 2018-05-21:
Printing

Closed 2018-05-21.

Thread 17 (2018-04-17):

Antenna Mount

cglusky, 2018-04-17:
Single and dual antenna mounts using standard 14mm mount spacing.

Will include .25in holes for antenna cable sma/rpsma bulkhead mounts.

cglusky, 2018-04-17:
Could also be mounted to tilt mount

cglusky, 2018-04-17:
yes assuming you have the right bulkhead connector (the gold part with the jam nut).  sma vs rpsma can be a challenge but they are all the same hole size for mounting.  it's just the polarity of the port on the cable.

https://www.amazon.com/RP-SMA-Female-Pigtail-Antenna-Coaxial/dp/B01LL6HWL6/

cglusky, 2018-05-12:
Design done.  Print and test.  May need an angle mount for other use cases.

Closed 2018-05-12.

Thread 18 (2018-04-17):

Add More Mounting Holes to Cross Mounts

cglusky, 2018-04-17:
Cross mounts could use a least 14mm spaced holes.

Possibly 20mm on center if there is room

cglusky, 2018-04-17:
14mm on center to start

Closed 2018-04-17.

Thread 19 (2018-04-29):

Rebuild D300 with OmniBusF4v2

cglusky, 2018-04-29:
ArduCopter 3.6 is in beta and support for small race class FC's is included.  I have an OmnibusF4v2 Pro in the shop along with BLHeli ESC's.  This gear is likely a better match to digital FPV use case on D300.

I will finish the current build with PixFalcon; test fly; Autotune; and document.  Then pull it apart and repeat with OmniBus et al with ArduCopter 3.6.

I also do not have step by step pics of the current build so this will provide an opportunity to fix docs.

This will also put the docs in a alignment with latest ArduCopter, which is a big change (more 4.0 than 3.6 seems to me), so we do not need to repeat right after we complete docs for 3.5.

cglusky, 2018-05-12:
D300 initial build and docs will be done with OmniBusF4 FC.  Running cleanflight with a RsPi and Raspi Cam module.  FPV will be done with ezwifibroadcast and DroneBridge intitially.

Once there is more time then AC3.6 and Maverick wifibc can be documented as well.

fnoop, 2018-05-12:
Boo!

cglusky, 2018-05-12:
Understand.  I don't like it much either.  Maverick is not limiting factor.  It's my lack of time to try to figure out AC3.6 and OminBus.

The good news is the D500 build gets bumped up.  I just want to put the D300 to bed and get the D500 going so I can have a bit more room to strap on gear and play with Maverick, FrsKy telemetry, and WifiBC.

Can always circle back around to D300 once OmniBus support is figured out in AC.

cglusky, 2018-05-20:
My D300 build will be with betaflight and FPV gear.  Will leave 300 class builds with ArduPilot etc to @fnoop  and others.

Closed 2018-05-20.

Thread 20 (2018-04-29):

Build/Doc D500 Input Needed

cglusky, 2018-04-29:
Sked for this summer.

Need input on use case to build around...

Basic CV?
Basic survey?

What companion makes most sense?  Rpi Zero is on D300 so should this be RPi3?  Or ??

cglusky, 2018-05-12:
Bumping this up.  Going to build with PixRacer and Raspi0 and Raspi Cam in a servo tilt mount.

Closed 2018-05-12.

Thread 22 (2018-04-29):

D300 Basic Wiki

cglusky, 2018-04-29:
Get basic BOM and enough info up to help early adopters

fnoop, 2018-05-19:
Eager to build one of these, but can't without basic BoM and instructions!

cglusky, 2018-05-20:
Working more on it today.

cglusky, 2018-05-20:
https://github.com/goodrobots/DevFrame/wiki/Base-Frame-BOM

fnoop, 2018-05-21:
Can you confirm that the imperial screw sizes convert to metric as per this guide?
https://householdquotes.co.uk/uk-screw-sizes/

cglusky, 2018-05-21:
Yes thats a good guide. Also # 2 is 2mm and # 1 is 1.7mm. Should probably add my own chart to wiki

Closed 2018-05-20.

Thread 23 (2018-05-04):

Redesign Horizontal Cross Mounts

cglusky, 2018-05-04:
Current cross mounts take up too much vertical space and it requires one top and bottom of tube to use top and bottom of each pair of tubes for mounting equipment.

New design will more of a wish bone style and sit in the vertical center of the tubes.  Will allow for better use of space, as well as velcro/tape mount of devices/platforms on top AND bottom of same mount.  Will also allow for M3 captive nut placement.

Will include mounting holes for:
- 2 x 3.5mm with 30.5mm spacing and M3 nut insert on bottom
- 2 x 2.5mm holes for 4/M3 with 14mm spacing

Thread 24 (2018-05-04):

Design Vertical Cross Mounts

cglusky, 2018-05-04:
Same as new horizontal cross mounts but can be mounted between top and bottom sets of tubes.

Not sure how handy these will be but it's easy enough to be worth testing.

Will likely only have room for 2.5mm holes at 14mm spacing to use with standard sensor mount pattern.

Thread 25 (2018-05-04):

Feedback Needed:  Sensor Mount Hole Spacing

cglusky, 2018-05-04:
We have access to a limited amount of different sesnors such as GPS, Lidar and board cameras.  Need help with some feedback as early adopters do integration.

Sensor mount is currently set at 14mm between centers using # 4 or/M3 screws.  That hole spacing figure is somewhat arbitrary and was driven by the roll cage sensor mount area.  Pilot hole diameter was set by what is easy to source so don't think the diameter should change - this is about the spacing of sensor mount holes...

There are some mini flight controllers that use 20mm spacing but otherwise have not found sensors with a standard bolt pattern/spacing like motor mounts can use.

This needs to be firmed up soon as any sensor mount designed with the 14mm pattern will need to change with the spacing.

If we change the spacing to anything approaching 20mm the roll cage will need a slight redesign to make room for the new, wider pattern.

cglusky, 2018-05-12:
Probably too far gone now.  Could change in future if I am very convinced by more than one sensor or gadget using the same mounting pattern.  As of today it appears everything needs an adapter to go from X to Y spacing.  So might as well stick with 14mm as our standard.

Closed 2018-05-12.

Thread 26 (2018-05-10):

Design Motor Mount Wire Protection

cglusky, 2018-05-10:
Some people may want to bring wires into arm tubes at motor mount ends.  This will expose wires to crash damage.  Add wire protection/bumper option for such use cases.

cglusky, 2018-05-12:
Also included slots for prop guard spokes.  Has not been tested.

Closed 2018-05-12.

Thread 28 (2018-05-20):

Raspi Mount

cglusky, 2018-05-20:
Adapt from 14mm sensor mount on cross mount to raspi mounting holes

cglusky, 2018-05-20:
Raspi is M2.5 with 58 x 49 spacing

cglusky, 2018-05-20:
Tube is conductive and headers pins on bottom will be over tube.
 6mm spacing over wishbone should yield 8.5mm clearance from center of tube.

Thread 29 (2018-05-20):

Raspi Cover

cglusky, 2018-05-20:
A simple cover to protect raspi from shorts, dings, etc

cglusky, 2018-05-20:
Printing

Closed 2018-05-20.

Thread 30 (2018-05-20):

Enlarge antenna mount hole

cglusky, 2018-05-20:
Needs to be 6.5mm OD to avoid drilling

cglusky, 2018-05-20:
fixed

Closed 2018-05-20.

Thread 31 (2018-05-20):

TPE Feet

cglusky, 2018-05-20:
Landing gear can use some TPE feet.  Will provide shock protection.  Optional and similar goals can be met with simple hacks such as foam and tape.

cglusky, 2018-05-21:
Printing

Closed 2018-05-21.

Thread 33 (2018-05-21):

Collect Wiki Info

cglusky, 2018-05-21:
Collecting notes about what we need for a good d500 build....

- [x] Finish D500 Beta 4 Build
- [x] Test Fly
- [ ] AutoTune
- [ ] Analyze Logs for any big issues
- [x] Update Wiki with more instructions and info
- [x] Upload param file for D500
- [x] Sync STEP folder with STL Folder

cglusky, 2020-01-08:
Need to pull param file for current d500 build.  Document d500 as an option with details to follow if interest in this size frame.

cglusky, 2020-01-08:
When mRo releases F9P, if in budget, we will doc a d500 Mapper with a vibe isolated Sony A6000 running camera trigger and hotshoe sync.  Will likely need 12mm arm tubes for d500.

cglusky, 2020-01-08:
Could likely benefit from 10in props as well.

cglusky, 2020-02-10:
Closing this in favor of separate, smaller issues.

Closed 2020-02-10.

Thread 35 (2018-05-30):

Virbation Isolation Mount for Camera Tilt Servo

cglusky, 2018-05-30:
Servo tilt mount does not work in flight for camera.  Too much jello.

cglusky, 2020-01-08:
Appears to also be an issue with servo slop.  Will need a support opposite from servo shaft.

Thread 36 (2019-03-14):

Update all mounts to new 15mm spaced pilot holes

cglusky, 2019-03-14:
RC1 will use 1mm pilot holes vs through holes on end clamps and cross mounts.  All mounts need to be changed to support new spacing.

cglusky, 2020-01-08:
All mounts updated to new spacing

fnoop, 2020-01-08:
Commit?

What's the benefit/change of the new pilot holes?

cglusky, 2020-01-08:
Just standardizing everything going forward.  Had new designs with 15mm (essentially half of the 30mm made popular by small autopilots, which is actually 30.5 but I don't worry about the .5mm since printing and drilling have bigger tolerances) so they won out.  Any old mounts you have will still work as it's just a 1mm delta.  Maybe need a light ream with a drill bit but they will still work.

Closed 2020-01-12.

Thread 37 (2020-01-08):

Complete Multi Sensor Platform Mount

cglusky, 2020-01-08:
Have draft design of mount that should support import PXFlow clones or OpenMV with a TFMini.

The space on top of this support should also be good for RC RX or similar.

Intended to be mounted on rear giving the d300 or similar optical flow and range finder with current landing gear design.

This will be a two piece mount.  One for OpenMV/PXFLow and other for TFMini.

cglusky, 2020-01-09:
Closing in favor of #44

Closed 2020-01-09.

Thread 38 (2020-01-08):

Increase Size of RPi Camera Mounting Bracket

cglusky, 2020-01-08:
Reports of bracket on back of mount breaking too often during hard use.  Beef up and get rid of insert for nut as it is not helpful.

cglusky, 2020-01-08:
Done.

fnoop, 2020-01-08:
Awesome!  I can't see a commit?

cglusky, 2020-01-08:
Sorry, not committed yet.  Test printing and test fitting everything.  Taken me a couple days to get caught up on latest trends in sensors.  Just tracking down optical flow trends has been a pain in my ass.

Closed 2020-01-12.

Thread 39 (2020-01-08):

Test Non-ferrous Fasteners For GPS Mount

cglusky, 2020-01-08:
Test brass screws with mRO GPS/compass combo to see if we have fewer compass issues

fnoop, 2020-01-08:
What about nylon screws?

cglusky, 2020-01-08:
Good point.  Do you have any issues sourcing?  I have some here in shop but not sure they will be right sizes.  mRobo GPS cover is designed to be screwed in and capture GPS on the mount at same time.  But you could drill it out and use nylon bolt and nut.  The mount itself is designed to be screwed into roll cage but again you could use small nylon bolt/nut combo.

fnoop, 2020-01-08:
Yup easy peasy to get on ebay, most standard M sizes.  Also much easier to cut to size.

cglusky, 2020-01-09:
M2 nylon on order for testing.

cglusky, 2020-01-14:
If you use nylon they need to be M3 for required strength.

Closed 2020-01-14.

Thread 41 (2020-01-08):

Create Switch Mount Flat

cglusky, 2020-01-08:
Use Antenna Mount as template.  Need 8mm hole to hold safety switch.  Tired of not having the switch handy.

Closed 2020-01-12.

Thread 42 (2020-01-08):

Create Switch Mount Angle

cglusky, 2020-01-08:
Same as flat.

cglusky, 2020-01-11:
Hole is just a bit tight.  Will increase by .2mm.  Same for both switch mounts.

Closed 2020-01-12.

Thread 43 (2020-01-08):

Mod RPi Cover for RPi4 w/ Fan

cglusky, 2020-01-08:
RPi4 needs active cooling to avoid thermal throttling.  Could use any of the new aluminum heat sinks but they are a bit heavy.

Going to try this:
https://www.amazon.com/gp/product/B07W3MJ9Y2/

Likely plugged into 3.3v based on reviews.

So RPi cover will need to support.

fnoop, 2020-01-08:
Yes good idea to give the option, but anything flying needs much less of a heat sink, as the airflow over the chip itself should be sufficient

cglusky, 2020-01-08:
Figured there would enough bench testing and hot days in a hover it would be worth adding.  I can keep the original cover for RPi2/3 and those who do not need fan for 4.

cglusky, 2020-01-14:
Done in RC2

Closed 2020-01-14.

Thread 44 (2020-01-09):

Create SeeedStudio ThoneFlow Adapter Mount

cglusky, 2020-01-09:
Edit:  Multi Mount is being abstracting so we will create a small adapter to support.

Multi Mount currently supports TFMini, OpenMV and PXFlow.

Have a ThoneFlow on order as it is affordable and getting a bit easier to find.  It's also serial based and already supported by CX-OF drivers.

https://www.seeedstudio.com/ThoneFlow-3901U-UART-Serial-Version-PMW3901-Optical-Flow-Sensor-p-4040.html

Once I have it in hand I can measure and add mounting holes to Multi Mount.  There should be room on mount for both TFMini and ThoneFLow, which will make for a nice package and min cost and weight.

cglusky, 2020-01-13:
This things is tiny...

11.5 x 14mm outside

Holes are 1.5mm diameter and in from edges 1.5mm to center.

Pay attention to orientation.

Create a small arrow in mount to point forward.

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

cglusky, 2020-01-14:
Arrow idea did not work out as no guarantee which way mounted.

cglusky, 2020-01-14:
Done in RC2

Closed 2020-01-14.

Thread 45 (2020-01-09):

Create Pi0 Mount

cglusky, 2020-01-09:
The current Multi Mount for optical flow and small lidar is showing promise.

Create a similar mount that can hold Pi0 with Sensor Mount Tilt for Camera Case.

Could also supply mounting holes for TFMini and TFlow.

cglusky, 2020-01-12:
Basic mount in RC2

Closed 2020-01-14.

Thread 47 (2020-01-11):

Missing RPi Mount Spacer

cglusky, 2020-01-11:
Used to be a small spacer that went under RPi Mount so the zipties on crossmounts cleared the mount vertically.  Looks like it got lost in RC1 folder shuffle.

Closed 2020-01-12.

Thread 48 (2020-01-11):

Support RPi Cam on Multi Mount

cglusky, 2020-01-11:
Turns out the Multi Mount will also hold RPi Cam with front half of case.  Will help to support those using it for optical flow and/or precland where camera needs to be fixed pointing down.

cglusky, 2020-01-13:
Going about this with a refactor of Multi Mount.

cglusky, 2020-01-14:
In RC2

Closed 2020-01-14.

Thread 49 (2020-01-11):

Create Multi Mount Flat

cglusky, 2020-01-11:
Current Multi Mount is designed to be mounted on front or back of box end to allow more space for sensors.  Creating a flat version that could be mounted to cross mounts could be handy.

cglusky, 2020-01-11:
Consider what happens if we print cross mounts in TPE or TPU to provide vibe isolation and use Multi Mount type flat surfaces for mounting.

cglusky, 2020-01-11:
Create some type of female receptacle in cross mount to capture male ends of a flat multi mount so we can reduce need for double siding tape or screws.

cross mount -> flat multi mount < - cross mount

Closed 2020-01-12.

Thread 50 (2020-01-11):

Mod Cross Mounts For Easier Mounting

cglusky, 2020-01-11:
Create some type of female receptacle in cross mount to capture male ends of a flat multi mount so we can reduce need for double sided tape or screws.

cross mount -> flat multi mount < - cross mount

_Originally posted by @cglusky in https://github.com/goodrobots/DevFrame/issues/49#issuecomment-573331587_

cglusky, 2020-01-12:
In RC1 merge

Closed 2020-01-12.

Thread 51 (2020-01-12):

Create Clamping Mounts For Rover

cglusky, 2020-01-12:
Adding a clamping mount or two for basic gear motors should be trivial and will allow for Rover support.  But let's get v1 d300 done first.

cglusky, 2020-02-13:
22mm, 25mm an 37mm look popular.  With 37mm being all over amazon for about 15 bucks each.

cglusky, 2020-04-26:
There is also an option to support direct mounting using screws.  Not sure which way works best right now.

Here's a list of hole patterns for popular gear motors:

.77 6-32 ActoBotics
.75 4-40 Pololu 6mm shaft
.625 4-40 Lynxmotion
.5 4-40 Pololu small

Thread 52 (2020-01-13):

Abstract/Standardize Multi Mount Interface

cglusky, 2020-01-13:
So it turns out it's likely better/easier to use standard 15/30mm mounting holes for this and the platforms.  Just create an adapter for each sensor that will mount on 15 or 30mm spacing.  That way the sensor mount can be used anywhere on frame including Multi Mount.

cglusky, 2020-01-14:
Done in RC2.

Closed 2020-01-14.

Thread 53 (2020-01-13):

Create Clone PX4Flow Adapter Mount

cglusky, 2020-01-13:
PX4Flow mounting pattern to 15mm pattern (and 30mm if it fits).

cglusky, 2020-01-14:
Supported by multi mount in RC2 but requires drilling.  Good enough considering there are better options for flow.

Closed 2020-01-14.

Thread 54 (2020-01-13):

Ensure All Hole Sizes Standard

cglusky, 2020-01-13:
Trying really hard to use a standard spec that make sense.  Besides 15 and 30mm spacing we need to watch pilot hole diameter.  Don't really want to ask people to start drilling a bunch, and if the part is not printed solid you can quickly run out of perimeter plastic around a small hole.

Frame => #6/M3.5 = 4mm Through hole and 2.5mm pilot
Mounts/Large Sensors => #4/M3 = 2.5mm pilot hole
Small Sensors => #2/M2 = 1.5mm pilot
Tiny Sensors => 1mm pilot

Also doc on wiki.

cglusky, 2020-01-14:
Done in RC2

Closed 2020-01-14.

Thread 55 (2020-01-13):

Create Landing Gear Spacers

cglusky, 2020-01-13:
Spacer to help create ground clearance if needed.  Also handy for more mounting locations.

Closed 2020-01-14.

Thread 56 (2020-01-13):

Improve Pi0 Mount

cglusky, 2020-01-13:
Standoffs 2mm taller

Create a version with cutout for GPIO pins

Add 15mm holes to middle

cglusky, 2020-01-14:
In RC2

Closed 2020-01-14.

Thread 57 (2020-01-13):

Create Multi Mount Short

cglusky, 2020-01-13:
Don't always need full length and if you use a short one horizontal you can mount another off the end vertically.

cglusky, 2020-01-14:
Might not need this if Double Angle Mount works out.

cglusky, 2020-01-14:
Original Multi Mount interface was abstracted and shortened 5mm.  This is no longer needed.

Closed 2020-01-14.

Thread 61 (2020-01-19):

Move Platforms Back To Center

cglusky, 2020-01-19:
Having them offset helps them clear tubes but creates some usability issues in regard to install.

Going to move them back to center.

cglusky, 2020-01-19:
Merged in RC3

Closed 2020-01-19.

Thread 62 (2020-01-19):

Add Pi0 Mount Tall

cglusky, 2020-01-19:
Add 2-3mm to Pi0 mount standoffs.  Allows for clearance with a small USB module on bottom and a heatsink on top.

cglusky, 2020-01-19:
Fixed in RC3

Closed 2020-01-19.

Thread 64 (2020-01-23):

Fix Thoneflow Mount Flat

cglusky, 2020-01-23:
Needs to be 3mm thick and remove standoffs. Helps print better.

cglusky, 2020-01-24:
Fixed in RC4

Closed 2020-01-24.

Thread 65 (2020-01-23):

Add Standoffs

cglusky, 2020-01-23:
Selection of standoffs on a thin raft. 2,4,6mm height. 4 each likely to ensure enough print time per layer for proper mix of cooling and layer adhesion.

Closed 2020-01-25.

Thread 68 (2020-01-28):

Add 12mm Arm Tube Clamps

cglusky, 2020-01-28:
12mm tubes needed for stiffness for weight and arm length.  And they also look better which is a valid degree of quality.

Closed 2020-02-03.

Thread 71 (2020-01-29):

Mod Cross Mount For Fastener Clearance

cglusky, 2020-01-29:
Current design has holes.  Makes it too hard to access inner area if using a nut on something like a standoff.  Connect holes to produce slot with proper tool clearance.

Closed 2020-02-03.

Thread 74 (2020-02-03):

Test Print Cross Mount Slot In TPU

cglusky, 2020-02-03:
See how the Cross Mount Center Slot prints in TPU to use as vibe isolation with a Platform.

cglusky, 2020-02-04:
Print quality is OK and it feels like it should work with platform.

Need to check vibe levels from flight logs before approved.

cglusky, 2020-02-05:
Checks good.

Closed 2020-02-05.

Thread 75 (2020-02-04):

Platform Spacing Not 30 x 30

cglusky, 2020-02-04:
30mm in one direction but not the other.  Fix so it's 30 x 30.

Closed 2020-02-05.

Thread 81 (2020-02-10):

Add mount support for Nvidia Jetson Nano

fnoop, 2020-02-10:
Jetson Nano is a very popular board, along with Raspberry Pi.  Has a different mount size, would be nice to have it supported.

cglusky, 2020-02-10:
Does it have mounting holes?  I don't have one and the pics I see don't show any.

I am uploading a step file from nvidia to see.  This make a board without any mounting holes thing seems to be a trend lately.  Annoying for those of us in the real world.

cglusky, 2020-02-10:
OK.  Got them on the CAD file.

cglusky, 2020-02-10:
86 x 58 and appear to be expecting M2.5

Closed 2020-02-10.

Thread 83 (2020-02-10):

Add mRo Sam Mini GPS Mount

cglusky, 2020-02-10:
Have one on hand for d300.  Needs mount.  No mounting holes so will do a two part design with holes on outside corners.

cglusky, 2020-04-17:
Pushed to v2 as it's not critical.

Thread 91 (2020-02-22):

Change Folder Names To Reflect Tube Size

cglusky, 2020-02-22:
Right now the two different arm size parts are under
-Frame
  -d300
  -d500

change to
-Frame
  -10mm Arms
  -12mm Arms

cglusky, 2020-02-22:
done

Closed 2020-02-22.

Thread 92 (2020-02-22):

Check all Images for 80% and Centered

cglusky, 2020-02-22:
Setting image utility class to .align-center and width="80%"

This seems to look and flow the best across different devices and window sizes

cglusky, 2020-02-23:
Done.  Some ended up as float: left at 40% and forcing a clear left between blocks when required.

Closed 2020-02-23.

Thread 95 (2020-02-24):

Add Fastener Resources

cglusky, 2020-02-24:
M2 and M3 standoffs.

Anti vibration standoffs

Nylon

Closed 2020-04-05.

Thread 97 (2020-02-25):

See if copper tape is doing anything

cglusky, 2020-02-25:
using copper tape on bottom of GPS mount.  could also be al foil. aspirin or vitamin?

https://ardupilot.org/copter/docs/common-compass-setup-advanced.html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

fnoop, 2020-02-26:
I used copper tape to shield the bottom of gps mount with minimal success.  Turns out much more important to shield radiators (usb3 plugs are a massive radiator).  Note if you shield the gps mount it should be connected to the gps groundplane to be really effective.
You can get EMI shielding material which is much more effective but it's quite expensive.

cglusky, 2020-02-26:
if i have time i will see if it makes any measurable difference to ground/drain the shielding.

cglusky, 2020-04-24:
issues like this likely best served via a blog post and any relevant results then baked back into docs.

Thread 98 (2020-04-16):

Consider embedding 3D part views into docs

SamuelDudley, 2020-04-16:
Github has a nice 3D viewer for stl files as per this screen shot
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
https://github.com/goodrobots/devFrame/blob/master/stl/Frame/devFrame%20Landing%20Gear%20Spacer.stl

it looks like this viewer can be embedded in a webpage:
https://help.github.com/en/github/managing-files-in-a-repository/3d-file-viewer#embedding-your-model-elsewhere

Perhaps this would be useful to add into the docs?

cglusky, 2020-04-16:
That was original plan.  Concerned it would become a performance issue if we used it more than once per page. And if I break out a separate page per part I start to recreate what already exists on repo.

SamuelDudley, 2020-04-16:
Okay, no worries!

Closed 2020-04-16.

Thread 106 (2020-04-23):

jekyll bundle version

fnoop, 2020-04-23:
When trying to build the odcs with jekyll, getting this error:
```
Notice: /Stage[main]/Maverick_web::Maverick_docs/Exec[build-devframe_docs]/returns: /usr/lib/ruby/2.5.0/rubygems.rb:289:in `find_spec_for_exe': can't find gem bundler (>= 0.a) with executable bundle (Gem::GemNotFoundException)
Notice: /Stage[main]/Maverick_web::Maverick_docs/Exec[build-devframe_docs]/returns: 	from /usr/lib/ruby/2.5.0/rubygems.rb:308:in `activate_bin_path'
Notice: /Stage[main]/Maverick_web::Maverick_docs/Exec[build-devframe_docs]/returns: 	from /usr/local/bin/bundle:23:in `<main>'
Error: '/usr/local/bin/bundle exec jekyll build' returned 1 instead of one of [0]
Error: /Stage[main]/Maverick_web::Maverick_docs/Exec[build-devframe_docs]/returns: change from 'notrun' to ['0'] failed: '/usr/local/bin/bundle exec jekyll build' returned 1 instead of one of [0]
```

The issue is explained here:
https://bundler.io/blog/2019/05/14/solutions-for-cant-find-gem-bundler-with-executable-bundle.html

Doing a system update of gem (`gem update --system`) is not a good solution - it seems to update some fundamental components enough that it sends puppet absolutely haywire and completely breaks `maverick configure`.  Updating ruby is not a sensible option on most systems.   The easiest fix is simply to remove the BUNDLED version in Gemfile.lock:
```
BUNDLED WITH
-   2.1.2
```

cglusky, 2020-04-23:
Can do that for each versioned release.  Just going to come back with each commit for working branch.  And I am working from master for docs.  Does that work for you?

fnoop, 2020-04-23:
These comments suggest to bump the version up to something high, but that doesn't work.
https://github.com/rubygems/bundler-features/issues/88#issuecomment-109220888
https://github.com/rubygems/bundler/issues/3697#issuecomment-108100899

I guess the only option is either to keep manually removing it from the lockfile, or fix a version of bundler that doesn't get changed for as long as possible, so we can document it for other contributors, and can be set as a parameter in maverick manifest for the devframe docs.

Seems like a really strange thing to do - reading the comments above and lots of other similar ones not one that a lot of ruby developers agree with..

cglusky, 2020-04-23:
seems to be restrictive.  and not clear if there is a reason, which never makes things better.  right now my last local build totally locked up.  and all i did was add a few images.  so have to get that fixed first.

cglusky, 2020-04-23:
https://stackoverflow.com/questions/18383402/how-to-specify-minimum-bundler-version-for-gemfile

don't know if that helps

fnoop, 2020-04-24:
It's not a minimum version that's needed - it's the *exact* version.  I had bundler 2.1.4 installed (the latest, I think, currently), but it needed exactly 2.1.2 to work.  Any other version produced the same cryptic error.

Thread 109 (2020-04-24):

Absolute URLs hardcoded into markup

fnoop, 2020-04-24:
When trying to load the compiled site through nginx, it fails because links/images/references are all hardcoded with '/devFrame' prefix.  URLs should ideally be relative, so the site can be hosted anywhere.
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

cglusky, 2020-04-24:
not hardcoded.  pulls from config.yaml.  via tokens inserted into liquid template syntax.

`[build section]({{ site.baseurl }}/docs/build-intro/) `

`# Site
locale: "en-US"
title: "devFrame docs"
description: >- # this means to ignore newlines
  "devFrame is an Open Source quadcopter and rover frame design."
url: "https://goodrobots.github.io"
baseurl: "/devFrame"
stlurl: "/blob/master/stl/"`

fnoop, 2020-04-24:
Ah!  Cool ok, I'll look into that, either making it relative or perhaps adding a custom config.yaml for maverick.  Is there a particular reason you've moved it to /devFrame rather than . or /?

cglusky, 2020-04-24:
did not want to hog root as it probably should be some sort of index to goodrobots projects.  eventually.  my understanding is to host from root of github org you have to create a separate repo as well.

cglusky, 2020-04-24:
likely be best to run a custom config yaml in case someone does want to create a PR from maverick devframe docs.  the baseurl property really helps for local dev so you can easily mirror githib setups.

Thread 114 (2020-04-24):

Update BOM

cglusky, 2020-04-24:
Build Intro has the master BOM; it's short a few things.  Make sure to go through each step's BOM and copy items into master as required.

Thread 120 (2020-07-17):

Add mRo Location One and mRo ZED-F9 GPS cases

adalta87, 2020-07-17:
I have used this gps on other builds with great success it has a RM3100 compass in it which is far better than the others. I have asked MRO for a cad file so I could start fiddling around with it. I also asked for a cad file for the new ZED-F9 L1/L2 gps they have which are also amazing and these two would be great additions to the rover build as well. They are also CAN sensor so they free up serial ports for other bells and whistles.

cglusky, 2020-07-18:
Been watching mRo's new releases.  This would be a great add.  I am in class full time until mid August so devFrame work has slowed for me.
