goodrobots/devFrame/(commit log)

2018-03-31 v1 CAD files
    [DevFrame 19mm Motor Mount Half v1.step, DevFrame 19mm Motor Mount Half v1.stl, DevFrame Arm Tube Clamp v1.step, DevFrame Arm Tube Clamp v1.stl, DevFrame Box End Clamp A v1.step, DevFrame Box End Clamp A v1.stl, DevFrame Box End Clamp B v1.step, DevFrame Box End Clamp B v1.stl]
2018-04-11 Add Roll Cage and Landing Gear
    [DevFrame Box End Clamp Landing Gear v1.step, DevFrame Box End Clamp Landing Gear v1.stl, DevFrame Box End Clamp Roll Cage v1.step, DevFrame Box End Clamp Roll Cage v1.stl]
2018-04-16 beta 2 changes
    [DevFrame 19mm Motor Mount Half.stl, DevFrame Arm Tube Clamp.stl, DevFrame Box End Clamp A Roll Cage.stl, DevFrame Box End Clamp A v1.step, DevFrame Box End Clamp A v1.stl, DevFrame Box End Clamp A.step, DevFrame Box End Clamp A.stl, DevFrame Box End Clamp B v1.step]
2018-04-16 beta 2 clean-up
    [DevFrame 19mm Motor Mount Half.step, DevFrame Arm Tube Clamp.step, DevFrame Box End Clamp A Roll Cage.step, DevFrame Box End Clamp Landing Gear v1.step, DevFrame Cross Mount ZipTie v1.step]
2018-04-17 Adding mounts
    [DevFrame Cross Mount ZipTie.stl, DevFrame GPS Mount 40x40.stl, DevFrame Sensor Mount Tilt.stl, RasPi Cam Mount Front.stl, RasPi Cam Mount Rear Tilt.stl]
2018-05-12 Beta 3 changes
    [DevFrame Antenna Mount Flat.stl, DevFrame Cross Mount Wishbone .step, DevFrame Cross Mount Wishbone.stl, DevFrame Cross Mount ZipTie v1.step, DevFrame Cross Mount ZipTie.stl, DevFrame GPS Mount 30x30.step, DevFrame GPS Mount 30x30.stl, DevFrame GPS Mount 40x40.stl]
2018-05-12 Correct file
    [DevFrame Motor Mount Bttm Half Protect.stl]
2018-05-21 Beta 4 prep
    [DevFrame Antenna Mount Flat.stl, DevFrame GPS Cover MRo.stl, DevFrame GPS Mount MRo.stl, DevFrame Landing Gear Feet TPE.stl, DevFrame Micro Servo Mount.stl, DevFrame Micro Servo Sensor Mount.stl, DevFrame Motor Mount Bttm Half Protect.stl, DevFrame Motor Mount Half Gaurd Slots.stl]
2018-05-24 Fix spelling
    [DevFrame Motor Mount Half Guard Slots.stl, DevFrame Motor Mount Half Guard.stl]
2018-05-24 Remove old file
    [DevFrame Motor Mount Half Guard Slots.stl]
2018-05-28 Add horizontal servo mount
    [DevFrame Micro Servo Mount Horizontal.stl]
2020-01-09 File and Folder Cleanup
    Standard folder structure and file names. Also closes #38
    [DevFrame Landing Gear Feet TPE.stl, DevFrame Micro Servo Mount Horizontal.stl, DevFrame Micro Servo Mount.stl, DevFrame Micro Servo Sensor Mount.stl, DevFrame Motor Mount Half Guard.stl, DevFrame Motor Mount Protect .step, devFrame Antenna Mount Flat.stl, devFrame Arm Tube Mount 10mm.step]
2020-01-09 TFMini Fixes
    Added Benewake folder and closes #11
    [devFrame TFMini Mount Angle.step, devFrame TFMini Mount Angle.stl, devFrame TFMini Mount Flat.stl, devFrame TFMini Mount Straight.step]
2020-01-09 Sensor Mount
    Updated to 15mm spacing and a bit bigger for strength.
    [devFrame Sensor Mount Tilt.step, devFrame Sensor Mount Tilt.stl]
2020-01-09 RPi Mount
    15mm spacing
    [devFrame RPi Mount Adapter Bottom.stl, devFrame RPi Mount Adapter Top.stl, devFrame RPi Mount.step, devFrame RPi Mount.stl]
2020-01-09 Multi Mount
    Multi mount updated to support TFMini, OpenMV and PXFlow and closes #37
    [devFrame Multi Mount.stl, devFrame RPi Cam Case Tilt.step]
2020-01-09 Cross Mount Vertical
    adding vertical back into release
    [devFrame Cross Mount Vertical.step, devFrame Cross Mount Vertical.stl]
2020-01-09 Box End Roll Cage
    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
    [devFrame Box End Roll Cage.step, devFrame Box End Roll Cage.stl]
2020-01-09 Box End Rounded
    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
    [devFrame Box End Rounded.step, devFrame Box End Rounded.stl]
2020-01-09 Box End Square
    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
    [devFrame Box End Square.step, devFrame Box End Square.stl]
2020-01-09 Cross Mount
    15 and 30mm spacing
    [devFrame Cross Mount.step, devFrame Cross Mount.stl]
2020-01-09 RPi Cam Mount Front and Rear
    Bigger and stronger mounting
    [devFrame RPi Cam Case Tilt.step, devFrame RPi Cam Mount Front.step, devFrame RPi Cam Mount Front.stl, devFrame RPi Cam Mount Rear Tilt.step, devFrame RPi Cam Mount Rear Tilt.stl]
2020-01-09 Delete devFrame RPi Mount.step
    This and last commit closes #38
    [devFrame RPi Mount.step]
2020-01-09 Motor Mount Half
    No big changes. Standard will be with outboard protector.
    [devFrame Motor Mount Half 10mm.step, devFrame Motor Mount Half 10mm.stl]
2020-01-09 mRo GPS Mount
    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
    [devFrame GPS Mount MRo.stl, devFrame mRo GPS Mount.step, devFrame mRo GPS Mount.stl]
2020-01-09 mRo GPS Cover
    No big changes
    [devFrame GPS Cover MRo.stl, devFrame mRo GPS Cover.step, devFrame mRo GPS Cover.stl]
2020-01-09 GPS Mount 40x40
    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
    [devFrame GPS Mount 40x40.step, devFrame GPS Mount 40x40.stl]
2020-01-09 GPS Mount 30x30
    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
    [devFrame GPS Mount 30x30.step, devFrame GPS Mount 30x30.stl]
2020-01-09 Antenna Mount Flat
    15mm spacing and closes #36
    [devFrame Antenna Mount Flat.step, devFrame Antenna Mount Flat.stl]
2020-01-09 Switch Mount Flat
    Mount for safety switch added.
    [devFrame Switch Mount Flat.stl, devFrame TFMini Mount Angle.step, devFrame TFMini Mount Angle.stl]
2020-01-09 Siwtch Mount Angle
    Angle mount for safety switch closes #42 previous commit closes #41
    [devFrame Switch Mount Angle.step, devFrame Switch Mount Angle.stl]
2020-01-09 Antenna Mount Angle
    Adding angled antenna mount closes #40
    [devFrame Antenna Mount Angle.step, devFrame Antenna Mount Angle.stl]
2020-01-11 Rpi Mount Spacer
    fixes #47
    [devFrame RPi Mount Spacer.step, devFrame RPi Mount Spacer.stl]
2020-01-11 Fix Switch Mount Hole
    0.2mm larger hole for switch
    [devFrame Switch Mount Angle.step, devFrame Switch Mount Angle.stl, devFrame Switch Mount Flat.step, devFrame Switch Mount Flat.stl]
2020-01-12 Adding Platform
    Parts that support platform design closes #49 and #50
    [devFrame Box End Roll Cage Slot.step, devFrame Box End Roll Cage Slot.stl, devFrame Box End Rounded Slot.step, devFrame Box End Rounded Slot.stl, devFrame Cross Mount Offset Slot.stl, devFrame Platform Basic.step, devFrame Platform Basic.stl]
2020-01-12 RPi 0 Mount
    Adding basic Pi0 mount works best with platform.
    [devFrame RPi0 Mount.step, devFrame RPi0 Mount.stl]
2020-01-14 RPi0 Mount Fixes
    Removed middle lightening hole, added mid set of 15mm mounts and 2mm taller
    [devFrame RPi0 Mount.step, devFrame RPi0 Mount.stl]
2020-01-14 Platform Basic Fixes
    Changed to 15mm matrix of holes
    [devFrame Platform Basic.step, devFrame Platform Basic.stl]
2020-01-14 ulti Mount hole spacing
    7.5 x 15mm grid of holes
    [devFrame Multi Mount.step, devFrame Multi Mount.stl]
2020-01-14 Cross Mount Offset Fixes
    2.5mm holes and added step
    [devFrame Cross Mount Offset Slot.stl, devFrame Cross Mount Offset.step]
2020-01-14 RPi4 Fan Cover
    Cutout for RPi4 with fan and adding step, closes #43
    [devFrame RPi 4 Fan Cover.step, devFrame RPi 4 Fan Cover.stl]
2020-01-14 RPi0 Mount GPIO
    Cutout for GPIO pins. Has not been tested.
    [devFrame RPi0 Mount GPIO.step, devFrame RPi0 Mount GPIO.stl]
2020-01-14 Cross Mount Vertical
    Fixed pilot hole diameter.
    [devFrame Cross Mount Vertical.step, devFrame Cross Mount Vertical.stl]
2020-01-14 Cross Mount
    Fixes pilot hole diamter
    [devFrame Cross Mount.step, devFrame Cross Mount.stl]
2020-01-14 Update devFrame RPi0 Mount.step
    Adds another set of pilot holes in middle. Last commit to fix #54
    [devFrame RPi0 Mount.step]
2020-01-14 RPi Camera Mount Flat
    Rear has a flat with 15mm mounting pattern
    [devFrame RPi Cam Mount Rear Flat.stl, devFrame RPi Camera Case Rear Flat.step]
2020-01-14 Update RPi 2/3 COver
    Made heatsink slot bugger and moved camera cable slot to match better.
    [devFrame RPi Cover.step, devFrame RPi Cover.stl]
2020-01-14 Update RPi Covers
    Latest test print revealed need to make fan and heatsink slots bigger and to move cmaera cable slot. Fixes #43
    [devFrame RPi 4 Fan Cover.stl, devFrame RPi4 Fan Cover.step, devFrame RPi4 Fan Cover.stl]
2020-01-14 RPi COver File Name Cleanup
    Make file names model specific and standard
    [devFrame RPi3 Cover Heatsinks.step, devFrame RPi3 Cover Heatsinks.stl, devFrame RPi4 Cover Fan.step, devFrame RPi4 Cover Fan.stl]
2020-01-14 Adding Double ANgle Mount
    A more or less z shaped mount that is pure utility.
    [devFrame Double Angle Mount.step, devFrame Double Angle Mount.stl]
2020-01-14 Adding Seeed ThoneFlow Mount
    Adapts to 15mm mount
    [devFrame Seeed ThoneFlow Mount.step, devFrame Seeed ThoneFlow Mount.stl]
2020-01-14 Fixed Seeed ThoneFlow Mount
    Bigger standoffs to make it easier to print and assemble.
    [devFrame Seeed ThoneFlow Mount.step, devFrame Seeed ThoneFlow Mount.stl]
2020-01-14 2mm Holes Double Angle
    Reducing hole size t osupport more screw options
    [devFrame Double Angle Mount.step, devFrame Double Angle Mount.stl]
2020-01-14 Removed Arrow ThoneFlow
    Mount can be mounted in either direction so arrow had to go. Marking the ThoneFlow itself is the best way to avoid confusion.
    [devFrame Seeed ThoneFlow Mount.step, devFrame Seeed ThoneFlow Mount.stl]
2020-01-14 TFMini Mount improvement
    Added 15mm mount holes since you could potentially chain another mouunt from this one.
    [devFrame TFMini Mount Angle.step, devFrame TFMini Mount Angle.stl]
2020-01-14 TFMini Flat Improvements
    Added 15mm mounting holes
    [devFrame TFMini Mount Flat.step, devFrame TFMini Mount Flat.stl, devFrame TFMini Mount Straight.step]
2020-01-14 Adding CUAV PXFlow Mount
    [devFrame CUAV PX4Flow Mount.step, devFrame CUAV PX4Flow Mount.stl]
2020-01-14 Adding Ladning Gear Spacer
    closes #55
    [devFrame Landing Gear Spacer.step, devFrame Landing Gear Spacer.stl]
2020-01-19 Adding RPi0 Mount Tall fixes #62
    4mm taller stnadoffs to cealr heat sinks and USB OEM modules.
    [devFrame RPi0 Mount Tall.step, devFrame RPi0 Mount Tall.stl]
2020-01-19 Updating Platform
    Symmetrical and centered
    [devFrame Platform Basic.step, devFrame Platform Basic.stl]
2020-01-19 Centering Slot On Box End Parts
    [devFrame Box End Roll Cage Slot.step, devFrame Box End Roll Cage Slot.stl, devFrame Box End Rounded Slot.step, devFrame Box End Rounded Slot.stl, devFrame Box End Square Slot.step, devFrame Box End Square Slot.stl, devFrame Cross Mount Center.step, devFrame Cross Mount Center.stl]
2020-01-19 Fixed Landing Gear
    Corect version
    [devFrame Landing Gear.step, devFrame Landing Gear.stl]
2020-01-19 File Name Standards
    Cleaning up file names to avoid confusion
    [devFrame Cross Mount Center Slot.step, devFrame Cross Mount Center Slot.stl, devFrame Cross Mount Offset Slot.stl, devFrame Cross Mount Offset.step]
2020-01-21 Adding Platform Shim
    Brings platform level with cross mount when required
    [devFrame Platform Shim.step, devFrame Platform Shim.stl]
2020-01-22 Add TFlow Mount Angle
    With corresponding file name changes to support flat and angle
    [devFrame Seeed ThoneFlow Mount Angle.step, devFrame Seeed ThoneFlow Mount Angle.stl, devFrame Seeed ThoneFlow Mount Flat.step, devFrame Seeed ThoneFlow Mount Flat.stl, devFrame Seeed ThoneFlow Mount.stl]
2020-01-22 Making TFlow 3mm Thick
    Less worry about breaking if not printed solid
    [devFrame Seeed ThoneFlow Mount Angle.step, devFrame Seeed ThoneFlow Mount Angle.stl]
2020-01-22 Adding 3mm Spacers
    Handy utility parts
    [devFrame 3mm Spacer Long .stl, devFrame 3mm Spacer Long.step, devFrame 3mm Spacer Short .stl, devFrame 3mm Spacer Short.step]
2020-01-24 Simpler Thoneflow Flat Mount
    Removed tiny standoffs that did not print well and made it thicker to print better
    [devFrame Seeed ThoneFlow Mount Flat.step, devFrame Seeed ThoneFlow Mount Flat.stl]
2020-01-24 Adding Standoffs
    2,4,6mm tall standoffs on a raft for utility use. Closes #65
    [devFrame 246 Standoff Raft.step, devFrame 246 Standoff Raft.stl]
2020-01-25 Adding Landing Gear Feet
    closes #66
    [devFrame Landing Gear Foot TPE.step, devFrame Landing Gear Foot TPE.stl]
2020-01-28 Adding 12mm Arm Tube Clamp
    Supports d500
    [devFrame Arm Tube Clamp 12mm.step, devFrame Arm Tube Clamp 12mm.stl]
2020-01-28 Adding 12mm Motor Mount Half
    d500 Support. Closes #68 #69
    [devFrame Motor Mount Half 12mm.step, devFrame Motor Mount Half 12mm.stl]
2020-01-29 2mm Thicker Motor Mount
    Gives clearance for motor shaft coming out of motor
    [devFrame Motor Mount Half 12mm.step, devFrame Motor Mount Half 12mm.stl]
2020-01-29 Fixing Cross Mount
    Connecting two holws to make a slot for proper tool clearance. Fixes #71
    [devFrame Cross Mount.step, devFrame Cross Mount.stl]
2020-01-29 Croos Mount Slot Improvements
    Better clearnce for tools and fasteners
    [devFrame Cross Mount.step, devFrame Cross Mount.stl]
2020-01-29 Cross Mount Vertical Slot Fixes
    Creating tool and fastener clearance in slot.
    [devFrame Cross Mount Vertical.step, devFrame Cross Mount Vertical.stl]
2020-02-03 Removing Box End Slot Parts
    Not required
    Closes #72
    [devFrame Box End Roll Cage Slot.step, devFrame Box End Roll Cage Slot.stl, devFrame Box End Rounded Slot.step, devFrame Box End Rounded Slot.stl, devFrame Box End Square Slot.step, devFrame Box End Square Slot.stl]
2020-02-04 Platform Mount SPacing Fixes
    30 x 30mm spacing in both directions. Cleaned up file names. Closes #75
    [devFrame Platform Basic.stl, devFrame Platform Mount Shim.step, devFrame Platform Mount Shim.stl, devFrame Platform Mount.step, devFrame Platform Mount.stl, devFrame Platform Shim.stl]
2020-02-09 testing csv
    [3D_Parts.csv]
2020-02-09 path tests
    [printedParts.csv]
2020-02-10 moving files adding folders
    [printedParts.csv]
2020-02-10 Adding Jetson Nano Mounts
    [devFrame NVIDIA Jetson Nano Mount.stl, devFrame NVidia Jetson Nano Mount.step]
2020-02-10 add Jetson Nano
2020-02-12 update front
    [printedParts.csv]
2020-02-12 switching to MM Theme
2020-02-13 Adding CUAV Neo Mount
    Close #84
    [devFrame CUAV NEO V2 GPS Mount Flat.step, devFrame CUAV NEO v2 GPS Mount Angle.step, devFrame CUAV NEO v2 GPS Mount Angle.stl, devFrame CUAV NEO v2 GPS Mount Flat.stl]
2020-02-14 case change
2020-02-17 adding frame details
2020-02-19 moving para to quick start
2020-02-19 adding roesources and printing
2020-02-19 no more other frames
2020-02-20 improve flow
2020-02-20 better flow
2020-02-22 adding cables and conns
2020-02-22 tube details and place holders
2020-02-22 tube info
2020-02-22 adding parts structure
    [devFrame Arm Tube Clamp 12mm.step, devFrame Arm Tube Clamp 12mm.stl, devFrame Arm Tube Mount 10mm.step, devFrame Arm Tube Mount 10mm.stl, devFrame Motor Mount Half 10mm.step, devFrame Motor Mount Half 10mm.stl, devFrame Motor Mount Half 12mm.step, devFrame Motor Mount Half 12mm.stl]
2020-02-22 more screw info
2020-02-23 center button
2020-02-23 adding arm tube info
    [printedParts.csv]
2020-02-23 Fixing file names
    [devFrame Arm Tube Mount 12mm.step, devFrame Arm Tube Mount 12mm.stl]
2020-02-23 fix file name and add print profiles
    [devFrame Landing Gear Cap TPU.step, devFrame Landing Gear Cap TPU.stl, printedParts.csv]
2020-02-23 link print settings back to parts
2020-02-24 basic frame pics
2020-02-24 adding bom
2020-02-26 adding base frame info
2020-02-28 arm tube info
2020-03-01 base frame complete
2020-03-02 tube clarity
2020-03-02 adding to BOM
2020-04-13 Standoff details
2020-04-16 Power planning info
2020-04-17 More power details
2020-04-17 Power adds
2020-04-19 wire and conn info closes #100
2020-04-19 tubes in resources closes #99
2020-04-19 frame size etc closes #101
2020-04-20 power system
2020-04-20 esc telem
2020-04-21 motors and esc's installed
2020-04-21 correct printed parts
2020-04-21 fix BOM
2020-04-23 adding battery page and more images
2020-04-23 fixing gitignore
    [printedParts.csv]
2020-04-25 60mm on center
2020-04-25 BOM details
2020-04-25 battery installed
2020-04-26 more cable info
2020-05-04 motor test
2020-05-05 motor test link
2020-05-26 Bump activesupport from 6.0.2.2 to 6.0.3.1 in /docs
    Bumps [activesupport](https://github.com/rails/rails) from 6.0.2.2 to 6.0.3.1.
    - [Release notes](https://github.com/rails/rails/releases)
    - [Changelog](https://github.com/rails/rails/blob/v6.0.3.1/activesupport/CHANGELOG.md)
    - [Commits](https://github.com/rails/rails/compare/v6.0.2.2...v6.0.3.1)
2023-12-11 Bump activesupport from 6.0.3.1 to 6.1.7.5 in /docs
    Bumps [activesupport](https://github.com/rails/rails) from 6.0.3.1 to 6.1.7.5.
    - [Changelog](https://github.com/rails/rails/blob/v7.1.2/activesupport/CHANGELOG.md)
    - [Commits](https://github.com/rails/rails/compare/v6.0.3.1...v6.1.7.5)
    ---
    updated-dependencies:
    - dependency-name: activesupport
    dependency-type: direct:production
    ...
    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
